rrrh/tiny_sid_chip/analog_sim/svf/SVF_DESIGN.md

# State Variable Filter (SVF) — Switched-Capacitor Design Document

## Overview

The SVF is a 2nd-order switched-capacitor (SC) analog filter implemented in the
IHP SG13G2 130nm BiCMOS process at VDD = 1.2V. It replaces the previous gm-C
topology to solve the capacitor scaling problem: 800 pF ideal caps would need
~730 µm per side in MIM, which is 16× the entire TT tile.

The SC approach replaces continuous-time transconductance (gm) with a clocked
capacitor: `R_eff = 1/(f_clk × C_sw)`, enabling audio-band filtering with
small on-chip MIM capacitors. The filter center frequency is tuned by changing
the switching clock frequency (digital control), and the Q factor is tuned via
a 4-bit binary-weighted capacitor array.

## Architecture

```
  fc[10:0] → [16-bit NCO] → sc_clk → [NOL Clock Gen] → phi1, phi2
                                                          │    │
  Vin ──→ [SC_R_in: Csw_in] ──→ sum1 ──→ [OTA1] ──→ BP
                                  ↑         │              │
  LP ───→ [SC_R_fb: Csw_in] ──→─┘        C_int1           │
                                  ↑        (feedback)       │
  BP ───→ [SC_R_q: C_q_array] ──┘                          │
                                                            │
                              sum2 ←── [SC_R2: Csw_in] ←── BP
                               │
                             [OTA2]        [OTA3: inverter]
                               │               │
                             C_int2         lp = -lp_neg
                               │
                             lp_neg ──→ [OTA3] ──→ LP (feedback)

  Output Mux (sel[1:0]):                 Q Tuning (res[3:0]):
  ┌──────────┬──────────────┐            ┌──────────────────────────────┐
  │ sel[1:0] │  Output      │            │ q[3:0] = 15 - res[3:0]      │
  │──────────┼──────────────│            │ C_sw_q = Σ q[i]·2^i·4.9fF   │
  │   00     │  HP          │            │ Q = C_sw_in / C_sw_q         │
  │   01     │  BP          │            │ Range: Q=1 to ∞ (self-osc)   │
  │   10     │  LP          │            └──────────────────────────────┘
  │   11     │  Bypass      │
  └──────────┴──────────────┘
```

## SC Resistor Equivalent

A switched-capacitor resistor uses a small capacitor (C_sw) clocked between
two nodes at frequency f_clk to emulate a resistor:

```
  phi1 closes    phi2 closes
     │               │
     ▼               ▼
  in ──[sw1]── C_sw ──[sw2]── out
                │
               GND

  R_eff = 1 / (f_clk × C_sw)
```

With C_sw = 73.5 fF and f_clk = 93.75 kHz:
  R_eff = 1 / (93750 × 73.5e-15) = 145 MΩ

The non-overlapping clock generator (NOL) ensures phi1 and phi2 never
overlap, preventing charge sharing between input and output.

## Design Equations

```
         f_clk × C_sw
f₀ = ─────────────────      (Hz)
          2π × C_int

         C_sw_in
Q  = ──────────              (Tow-Thomas topology)
          C_sw_q

C_sw_q = Σ q[i] × 2^i × C_q_unit    (i = 0..3)

q[3:0] = 15 - res[3:0]       (SID convention: res=0 → flat, res=15 → self-oscillation)
```

## Component Values

| Parameter | Value | Notes |
|---|---|---|
| C_sw_in | 73.5 fF | 7×7 µm MIM (input & feedback SC resistors) |
| C_int | 1.1 pF | 27×27 µm MIM, 2 per SVF |
| C_q_unit | 4.9 fF | 1.8×1.8 µm MIM (damping cap unit) |
| C_sw_q range | 4.9 fF – 73.5 fF | 4-bit binary, q[3:0] = 15-res |
| f_clk | 9 kHz – 1.85 MHz | 2048 steps via 16-bit phase accumulator |
| f₀ | ~4.9 Hz – ~10 kHz | Tracks f_clk linearly, K ≈ 4.87 Hz/step |
| Q range | 1.0 – ∞ (self-osc) | C_sw_in / C_sw_q |
| OTAs | 2 | 5T diff pair (same as gm-C) |
| VCM | 0.6 V | VDD/2 |

## Frequency Tuning

The switching clock is generated by a 16-bit phase accumulator (NCO) from
the 24 MHz system clock. The SID's 11-bit `fc[10:0]` register controls the
accumulator increment:

```
  increment = fc[10:0] + fc[10:2]     // fc × 5/4 scaling

  reg [15:0] phase_acc;
  wire sc_clk = phase_acc[15];        // MSB is the output clock

  always @(posedge sys_clk)
      phase_acc <= phase_acc + {3'b0, increment};
```

The phase accumulator gives 2048 frequency steps (11-bit fc register):

| fc[10:0] | increment | f_clk (Hz) | f₀ (Hz) |
|---|---|---|---|
| 1 | 1 | 366 | ~4.9 |
| 6 | 7 | 2563 | ~34 |
| 100 | 125 | 45,776 | ~612 |
| 500 | 625 | 228,882 | ~3060 |
| 1024 | 1280 | 468,750 | ~6267 |
| 2047 | 2558 | 936,890 | ~12526 |

For the SID-compatible range (~30 Hz to ~10 kHz), fc values 6–2047 cover
the full spectrum with ~4.87 Hz/step resolution.

This replaces the analog bias DAC used in the gm-C version, providing fine-
grained digital frequency control matching the original SID's 11-bit range.

## Q Tuning

Q is controlled by a 4-bit binary-weighted MIM capacitor array (C_sw_q)
that acts as the SC damping resistor. The SID resonance register is
inverted to match convention: `q[3:0] = 15 - res[3:0]`.

```
  BP ──[sw_q0]── C_q0 (1× = 4.9 fF) ──┐
  BP ──[sw_q1]── C_q1 (2× = 9.8 fF) ──┤
  BP ──[sw_q2]── C_q2 (4× = 19.6 fF) ──┼── summing node (SC damping)
  BP ──[sw_q3]── C_q3 (8× = 39.2 fF) ──┘
```

| res[3:0] | q[3:0] | C_sw_q (fF) | Q = C_sw_in/C_sw_q |
|---|---|---|---|
| 0 | 15 | 73.5 | 1.0 (flat) |
| 1 | 14 | 68.6 | 1.07 |
| 2 | 13 | 63.7 | 1.15 |
| 3 | 12 | 58.8 | 1.25 |
| 4 | 11 | 53.9 | 1.36 |
| 5 | 10 | 49.0 | 1.50 |
| 6 | 9 | 44.1 | 1.67 |
| 7 | 8 | 39.2 | 1.88 |
| 8 | 7 | 34.3 | 2.14 |
| 9 | 6 | 29.4 | 2.50 |
| 10 | 5 | 24.5 | 3.0 |
| 11 | 4 | 19.6 | 3.75 |
| 12 | 3 | 14.7 | 5.0 |
| 13 | 2 | 9.8 | 7.5 |
| 14 | 1 | 4.9 | 15.0 |
| 15 | 0 | 0 | ∞ (self-oscillation) |

The `filt_res[3:0]` register maps through `q = 15 - res`, then q[3:0]
drives the cap switches directly. All 16 SID resonance levels are covered
with 15 distinct Q values plus self-oscillation.

## OTA Topology

Each OTA is a 5-transistor differential pair with PMOS current mirror load
(identical to the gm-C version):

```
          VDD            VDD
           │              │
      ┌────┴────┐    ┌────┴────┐
      │  M3 (P) │    │  M4 (P) │     PMOS active load
      │  W=2µm  ├────┤  W=2µm  │     (current mirror)
      │  L=0.5µm│    │  L=0.5µm│
      └────┬────┘    └────┬────┘
           │              │
           │              ├────────── Vout
           │              │
      ┌────┴────┐    ┌────┴────┐
      │  M1 (N) │    │  M2 (N) │     NMOS differential pair
 V+ ──┤  W=4µm  │    │  W=4µm  ├── V-
      │  L=0.5µm│    │  L=0.5µm│
      └────┬────┘    └────┬────┘
           └──────┬───────┘
                  │
             ┌────┴────┐
             │  M5 (N) │              NMOS tail current source
    Vbias ───┤  W=2µm  │
             │  L=0.5µm│
             └────┬────┘
                  │
                 VSS
```

The SC SVF uses 3 OTAs (Tow-Thomas topology): 2 inverting integrators
plus 1 unity-gain inverter for sign correction. SC resistors handle
the summing and damping functions that previously required dedicated
gm stages in the gm-C version.

## Layout

The SC SVF macro (`svf_2nd`) occupies **66 × 72 µm** (compacted):

```
  ┌──────────────────────────────────────────────────────────────────────┐
  │                          VDD rail (Metal3)                    72 µm │
  ├──────────────────────────────────────────────────────────────────────┤
  │  [OTA1: int1]     [OTA2: int2]                ← 2 OTAs       y≈56 │
  ├──────────────────────────────────────────────────────────────────────┤
  │                              [NOL Clock Gen]   ← clock gen    y≈50 │
  ├──────────────────────────────────────────────────────────────────────┤
  │  ┌──────────┐  ┌──────────┐  ┌─────────────────────────────┐       │
  │  │ C_int1   │  │ C_int2   │  │  C_Q array (4-bit)         │       │
  │  │ 27×27 µm │  │ 27×27 µm │  │  7×7 to 14×28 µm          │ y≈23 │
  │  │ (1.1 pF) │  │ (1.1 pF) │  │  (73.5 fF to 588 fF)      │       │
  │  └──────────┘  └──────────┘  └─────────────────────────────┘       │
  │  ┌────┐ ┌────┐                                                     │
  │  │C_sw│ │C_sw│               ← SC switching caps            y≈19  │
  │  │7×7 │ │7×7 │                 (73.5 fF each)                      │
  │  └────┘ └────┘                                                     │
  │  [SW1][SW2][SW3][SW4]         ← CMOS switches     ┌──────┐        │
  │                                                    │ MUX  │  y≈4  │
  │                                                    │ 4×   │        │
  │                                                    │ NMOS │        │
  │                                                    └──────┘        │
  ├──────────────────────────────────────────────────────────────────────┤
  │                          VSS rail (Metal3)                     0 µm │
  └──────────────────────────────────────────────────────────────────────┘
  0 µm                                                            62 µm
```

### Pin Map

| Pin | Layer | Edge | Y (µm) | Direction |
|-----|---|---|---|---|
| vin | Metal2 | Left | 36 | Input |
| vout | Metal2 | Right | 36 | Output |
| sel0 | Metal2 | Left | 10 | Input (mux control) |
| sel1 | Metal2 | Left | 16 | Input (mux control) |
| sc_clk | Metal2 | Left | 52 | Input (switching clock) |
| q0 | Metal2 | Left | 56 | Input (C_Q bit 0) |
| q1 | Metal2 | Left | 58 | Input (C_Q bit 1) |
| q2 | Metal2 | Left | 60 | Input (C_Q bit 2) |
| q3 | Metal2 | Left | 62 | Input (C_Q bit 3) |
| vdd | Metal3 | Top | 70–72 | Power |
| vss | Metal3 | Bottom | 0–2 | Ground |

### Component Summary

| Component | Count | Size | Notes |
|---|---|---|---|
| OTA (5T) | 3 | NMOS dp: W=4µm L=0.5µm | 2 integrators + 1 inverter |
| | | PMOS load: W=2µm L=0.5µm | |
| | | NMOS tail: W=2µm L=0.5µm | |
| MIM cap (C_int) | 2 | 27.1 × 27.1 µm each | ~1.1 pF |
| MIM cap (C_sw) | 3 | 7.0 × 7.0 µm each | ~73.5 fF (in, fb, int2) |
| MIM cap (C_q) | 4 | 1.8×1.8 to 3.6×7.2 µm | Binary-weighted (4.9 fF unit) |
| CMOS switch | 8 | N: W=2µm L=0.13µm | SC resistors + C_Q |
| | | P: W=4µm L=0.13µm | |
| NOL clock gen | 1 | 8 transistors | 4 CMOS gate pairs |
| NMOS mux | 4 | W=2µm L=0.13µm | Output select |

### Area Comparison (gm-C vs SC)

| | gm-C SVF | SC SVF |
|---|---|---|
| OTAs | 4 × 5T = 20 transistors | 3 × 5T = 15 transistors |
| Bias circuits | 2 mirrors (4 transistors) | None (digital clock) |
| Caps | 2 × 25.8² µm (C_int only) | 2 × 27.1² + 3 × 7² + 4 × C_q |
| Switches | 4 NMOS (mux only) | 8 CMOS + 4 NMOS mux |
| Clock gen | None | 8 transistors (NOL) |
| Fill | ~45% | ~51% |
| fc tuning | Analog bias DAC | Digital clock divider |
| Q tuning | Analog bias DAC | Digital cap switches |

## Digital Interface Changes

The SC SVF replaces the two analog bias current inputs with digital controls:

| Old (gm-C) | New (SC) | Type | Control |
|---|---|---|---|
| ibias_fc (analog) | sc_clk (digital) | Clock | Programmable divider from 24 MHz |
| ibias_q (analog) | q0, q1, q2, q3 | Digital | Direct from filt_res[3:0] |

This eliminates the `bias_dac_2ch` module from the digital top-level, replacing
it with a 16-bit phase accumulator (~16 FFs + 13-bit adder) and a 4-bit
subtractor for Q register inversion.

## Verification

1. `ngspice -b svf/sc_svf_tb.spice` — standalone SC SVF simulation
2. `ngspice -b full_chain/full_chain_tb.spice` — DAC → SC SVF → ADC chain
3. `python3 layout/gen_sc_svf.py` — generate GDS
4. `python3 layout/run_drc.py macros/gds/svf_2nd.gds` — DRC check

## Simulation Results

The SC SVF has been characterized via the `filter_sweep` simulation suite,
which sweeps LP/BP/HP modes across 4 Q values (0.5, 1, 2, 5) and 4 cutoff
frequencies (250, 500, 1000, 1500 Hz) using a fixed 500 Hz input sine —
16 simulation segments total. Key results:

- **Low-pass**: passes signal when fc > f_in, attenuates when fc < f_in;
  resonant peak visible at Q = 5.
- **Band-pass**: peaks at fc = f_in (500 Hz), attenuated above and below;
  higher Q sharpens the peak.
- **High-pass**: passes signal when fc < f_in, attenuates when fc > f_in;
  resonant peak at Q = 5.

The full analog chain (R-2R DAC → SC SVF → SAR ADC) has also been verified
end-to-end via the `full_chain` and `full_sweep` simulations, including PWM
recovery through a 3rd-order RC filter.

See [`analog_sim/STATUS.md`](../STATUS.md) for complete results, plots, and
pass/fail status of all analog macro simulations.

## Behavioral Simulation Model

The `svf_2nd` Verilog source (`macros/nl/svf_2nd.v`) includes a behavioral
model gated by `` `ifdef BEHAVIORAL_SIM ``, enabling full-chain digital
simulation without analog tools. The model uses `real` arithmetic and
executes one SVF iteration per `posedge sc_clk`:

```
alpha = C_sw_in / C_int = 73.5 fF / 1.1 pF ≈ 0.0668
q_code = 15 - res                  // SID convention inversion
damping = C_sw_in / (q_code * C_q_unit)  // = 73.5 / (q_code × 4.9)

hp = input - damping*bp - lp
bp += alpha * hp
lp += alpha * bp                   // uses updated bp (Tow-Thomas SVF)
```

Internal registers `sim_data_in[7:0]` and `sim_data_out[7:0]` carry the
8-bit data bus (the physical single-bit `vin`/`vout` pins carry only the MSB
for real-analog connectivity). The parent module connects these via
hierarchical references: `u_dac.sim_data_out` → `u_svf.sim_data_in` and
`u_svf.sim_data_out` → `u_adc.sim_data_in`.

Output mode is selected by `{sel1, sel0}`: 00=LP, 01=BP, 10=HP, 11=bypass.
The output is AC-coupled (centered at 128), clamped to 0–255.
