rrrh/tiny_sid_chip/verification/pwm_comp/doc/pwm_comp_schematic.md

# CACE Summary for pwm_comp

**netlist source**: schematic

| Parameter | Tool | Result | Min Limit  |  Min Value | Typ Target |  Typ Value | Max Limit  |  Max Value |  Status  |
| :--- | :--- | :--- | ---: | ---: | ---: | ---: | ---: | ---: | :---: |
| Input Offset Voltage | ngspice | vos | | | | | 50.0 mV |  10.376 mV | Pass ✅ |
| Trip Point | ngspice | trip_point | 0.4 V | 0.590 V | | | 0.8 V | 0.593 V | Pass ✅ |
| tPLH | ngspice | t_plh | | | | | 100.0 ns |  86.291 ns | Pass ✅ |
| tPHL | ngspice | t_phl | | | | | 100.0 ns | 1.323 ns | Pass ✅ |

## Plots

## offset_vs_corner

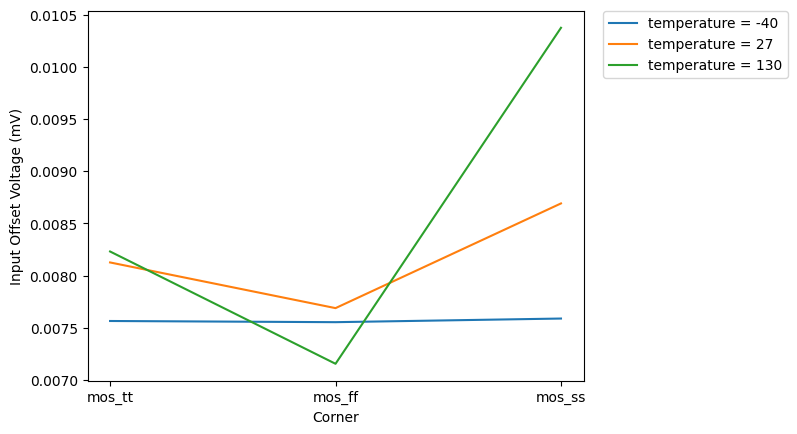
[picture p1: verification/pwm_comp/doc/pwm_comp/schematic/offset_vs_corner.png]
offset_vs_corner


## offset_vs_temp

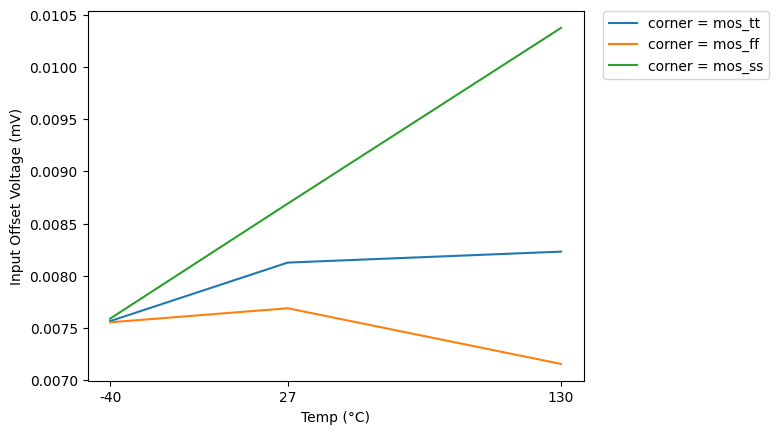
[picture p2: verification/pwm_comp/doc/pwm_comp/schematic/offset_vs_temp.png]
offset_vs_temp


## delay_vs_corner

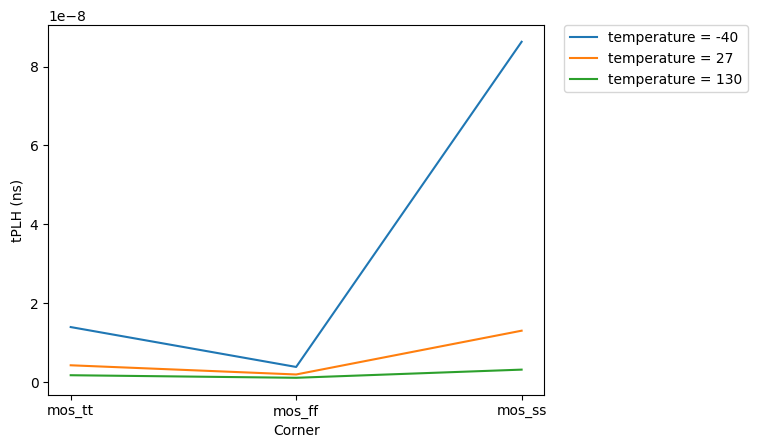
[picture p3: verification/pwm_comp/doc/pwm_comp/schematic/delay_vs_corner.png]
delay_vs_corner


## delay_vs_temp

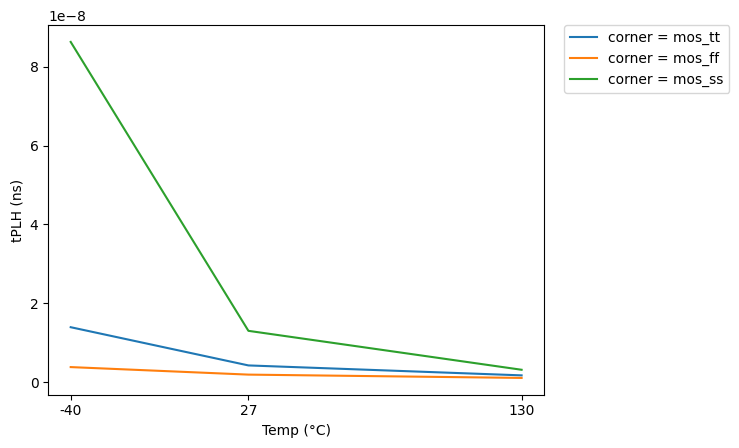
[picture p4: verification/pwm_comp/doc/pwm_comp/schematic/delay_vs_temp.png]
delay_vs_temp
