rrrh/tiny_sid_chip/docs/rc_filter.pdf

### uo_out[1]

PDM 1-bit @ 50 MHz

R1

1.0 kΩ

C2

1 µF

### Audio Out

to headphones
or amplifier

4.7 nFC1

fc =

1
2πR1C1

≈ 34 kHz with R1=1 kΩ, C1=4.7 nF

C2 is optional — blocks DC offset when driving an AC-coupled amplifier input
