rrrh/tiny_sid_chip/verification/sar_adc_8bit/doc/sar_adc_8bit_schematic.md

# CACE Summary for sar_adc_8bit

**netlist source**: schematic

| Parameter | Tool | Result | Min Limit  |  Min Value | Typ Target |  Typ Value | Max Limit  |  Max Value |  Status  |
| :--- | :--- | :--- | ---: | ---: | ---: | ---: | ---: | ---: | :---: |
| Resolve Time | ngspice | t_resolve | | | | | 5.0 ns | | Skip 🟧 |
| Correct Decision | ngspice | decision | 1.0 | | | | | | Skip 🟧 |
| INL | ngspice | inl | | | | | 0.5 LSB | | Skip 🟧 |
| DNL | ngspice | dnl | | | | | 0.5 LSB | | Skip 🟧 |
| INL | ngspice | inl | | | | | 0.5 LSB | | Skip 🟧 |
| DNL | ngspice | dnl | | | | | 0.5 LSB | | Skip 🟧 |
| Conversion Time | ngspice | conv_time_ns | | | | | 1000 ns | | Skip 🟧 |

## Plots
