rrrh/tiny_sid_chip/verification/svf_2nd/doc/svf_2nd_schematic.md

# CACE Summary for svf_2nd

**netlist source**: schematic

| Parameter | Tool | Result | Min Limit  |  Min Value | Typ Target |  Typ Value | Max Limit  |  Max Value |  Status  |
| :--- | :--- | :--- | ---: | ---: | ---: | ---: | ---: | ---: | :---: |
| Center Frequency | ngspice | f0 | any | | any | | any | | Skip 🟧 |
| BP Peak Gain | ngspice | peak_gain | -30.0 dB | | | | 20.0 dB | | Skip 🟧 |
| Measured Q | ngspice | q_meas | any | | any | | any | | Skip 🟧 |
| HF Gain | ngspice | hf_gain | -1.0 dB | | | | 1.0 dB | | Skip 🟧 |
| -3dB Frequency | ngspice | f_3db | any | | any | | any | | Skip 🟧 |
| DC Gain | ngspice | dc_gain | -1.0 dB | | | | 1.0 dB | | Skip 🟧 |
| -3dB Frequency | ngspice | f_3db | any | | any | | any | | Skip 🟧 |

## Plots
