rrrh/tiny_sid_chip/analog_sim/full_chain/full_chain_plot.png

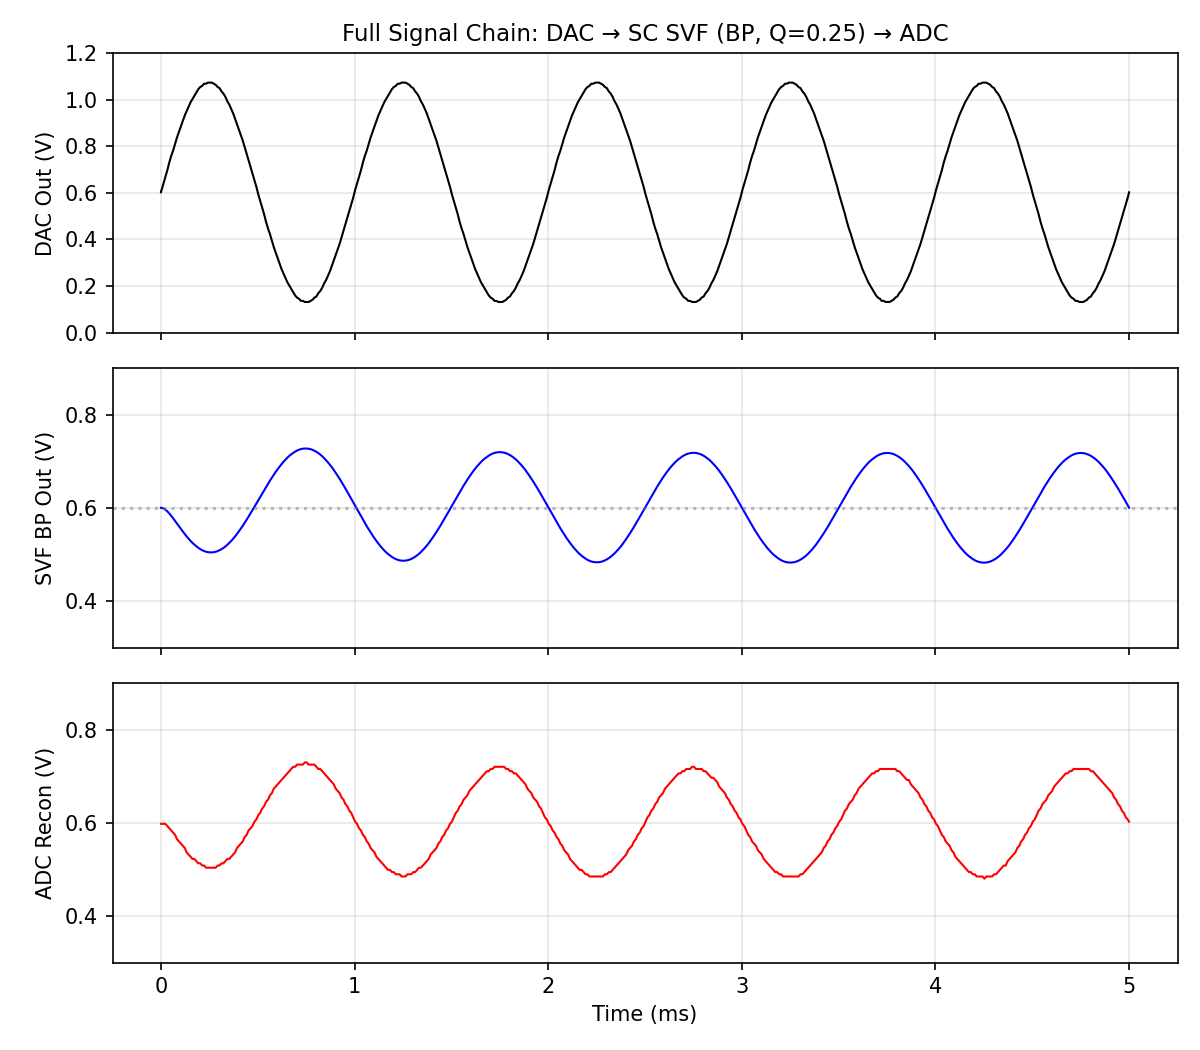
analog_sim/full_chain/full_chain_plot.png
