rrrh/tiny_sid_chip/analog_sim/full_chain/waveform_440.png

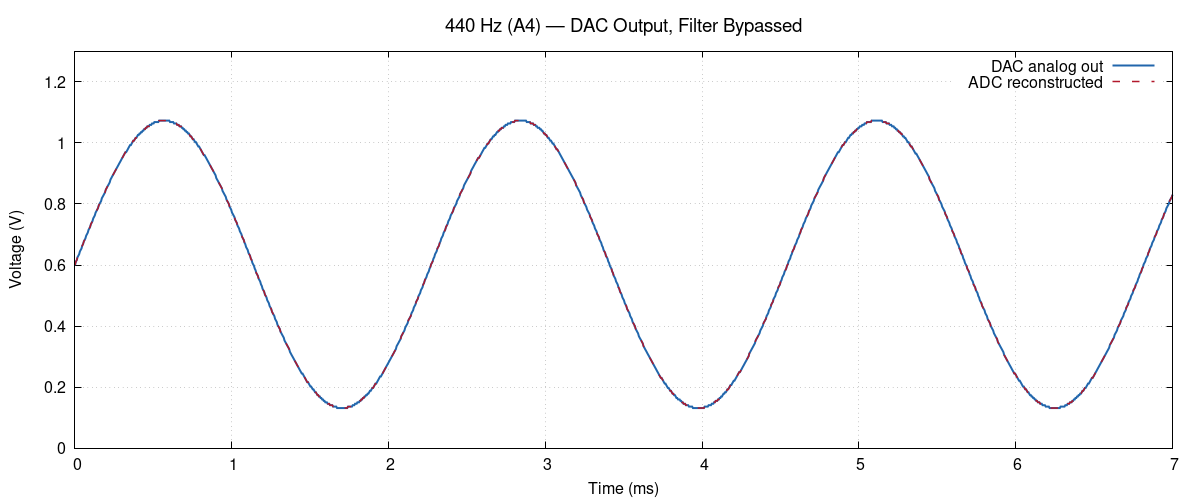
analog_sim/full_chain/waveform_440.png
