rrrh/tiny_sid_chip/analog_sim/full_chain/waveform_880.png

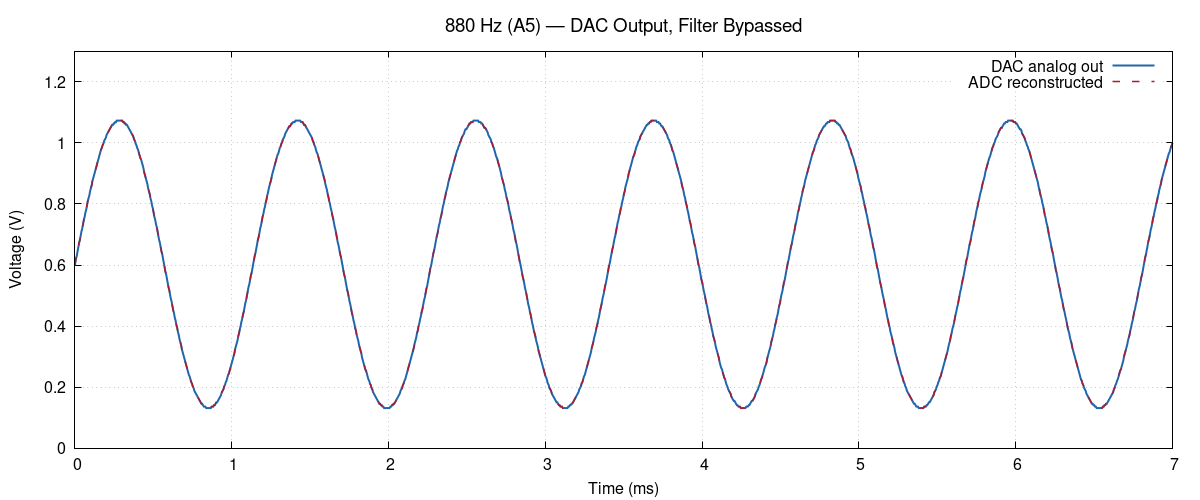
analog_sim/full_chain/waveform_880.png
