rrrh/tiny_sid_chip/analog_sim/sc_svf_summary.png

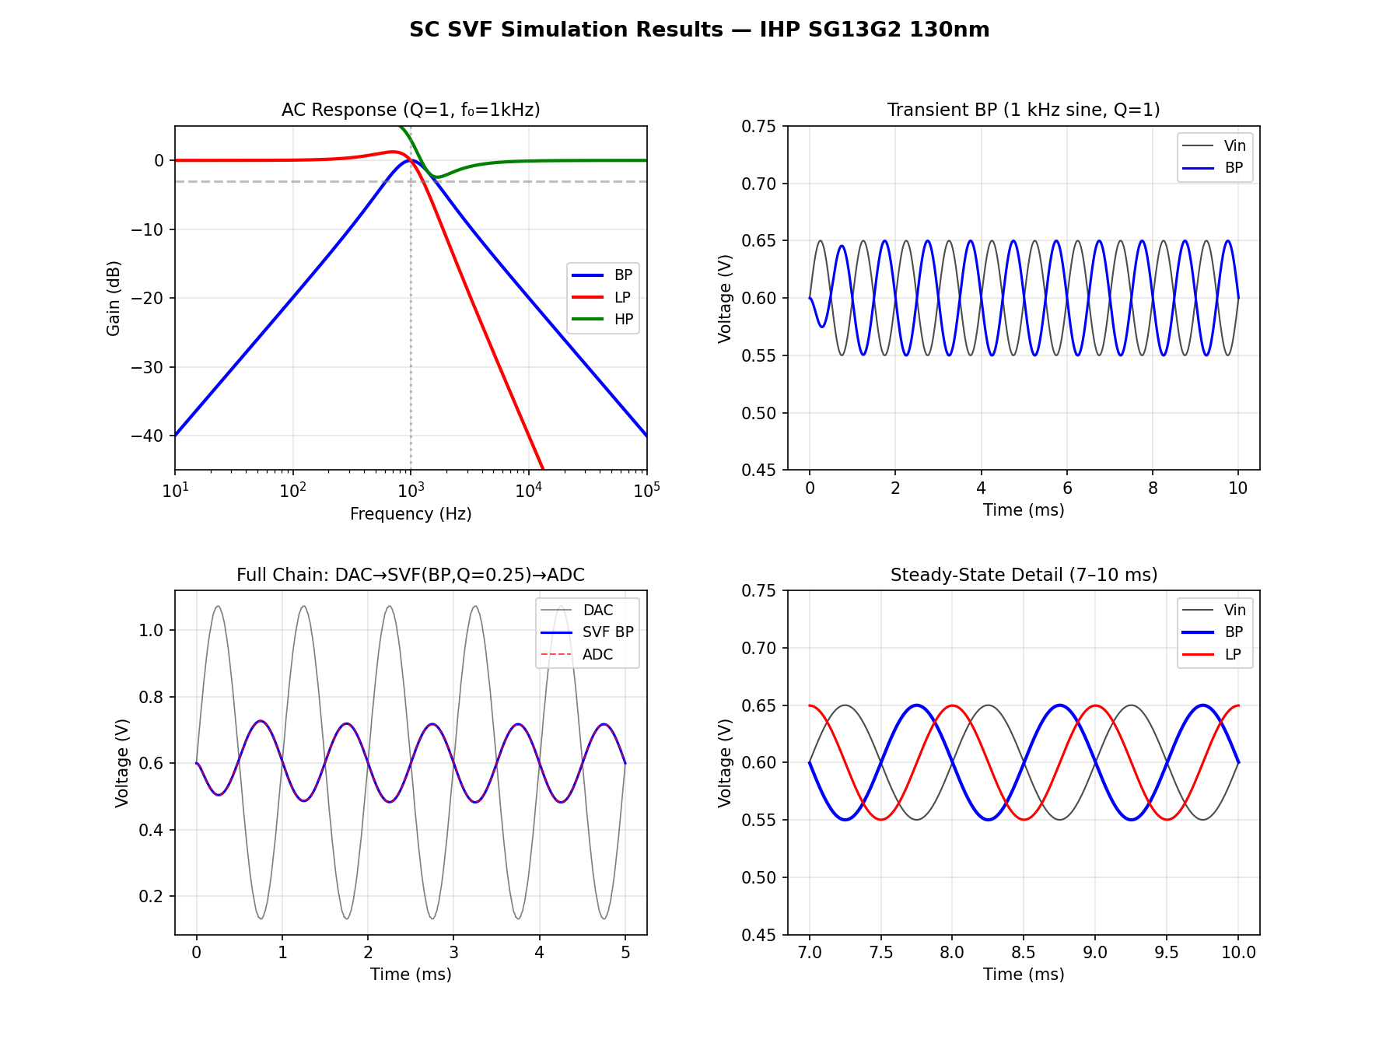
analog_sim/sc_svf_summary.png
