rrrh/tiny_sid_chip/analog_sim/svf/sc_svf_ac_response.png

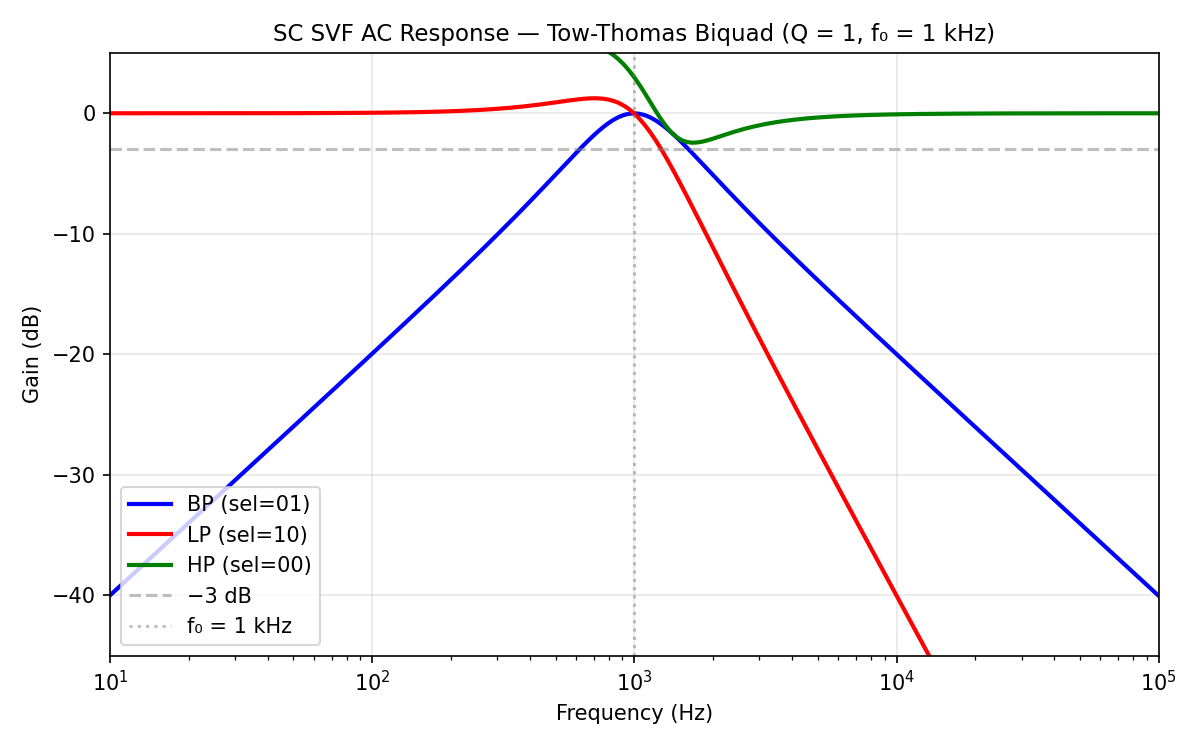
analog_sim/svf/sc_svf_ac_response.png
