rrrh/tiny_sid_chip/analog_sim/svf/sc_svf_transient.png

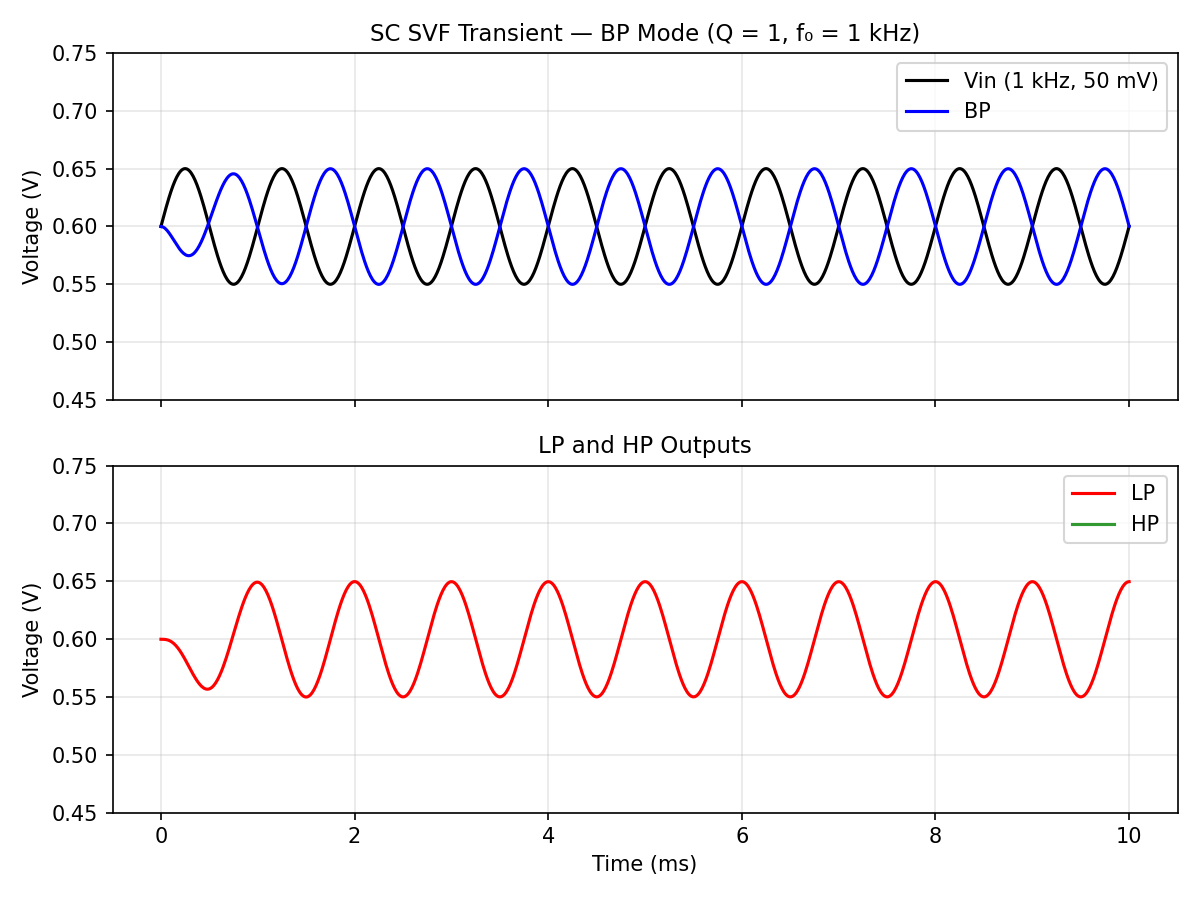
analog_sim/svf/sc_svf_transient.png
