rrrh/tiny_sid_chip/docs/adsr_fsm.png

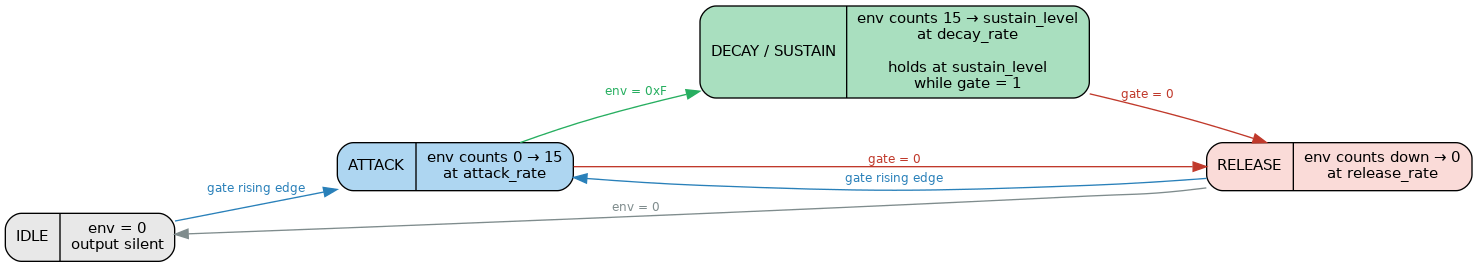
docs/adsr_fsm.png
