rrrh/tiny_sid_chip/docs/pwm_bode_plot.png

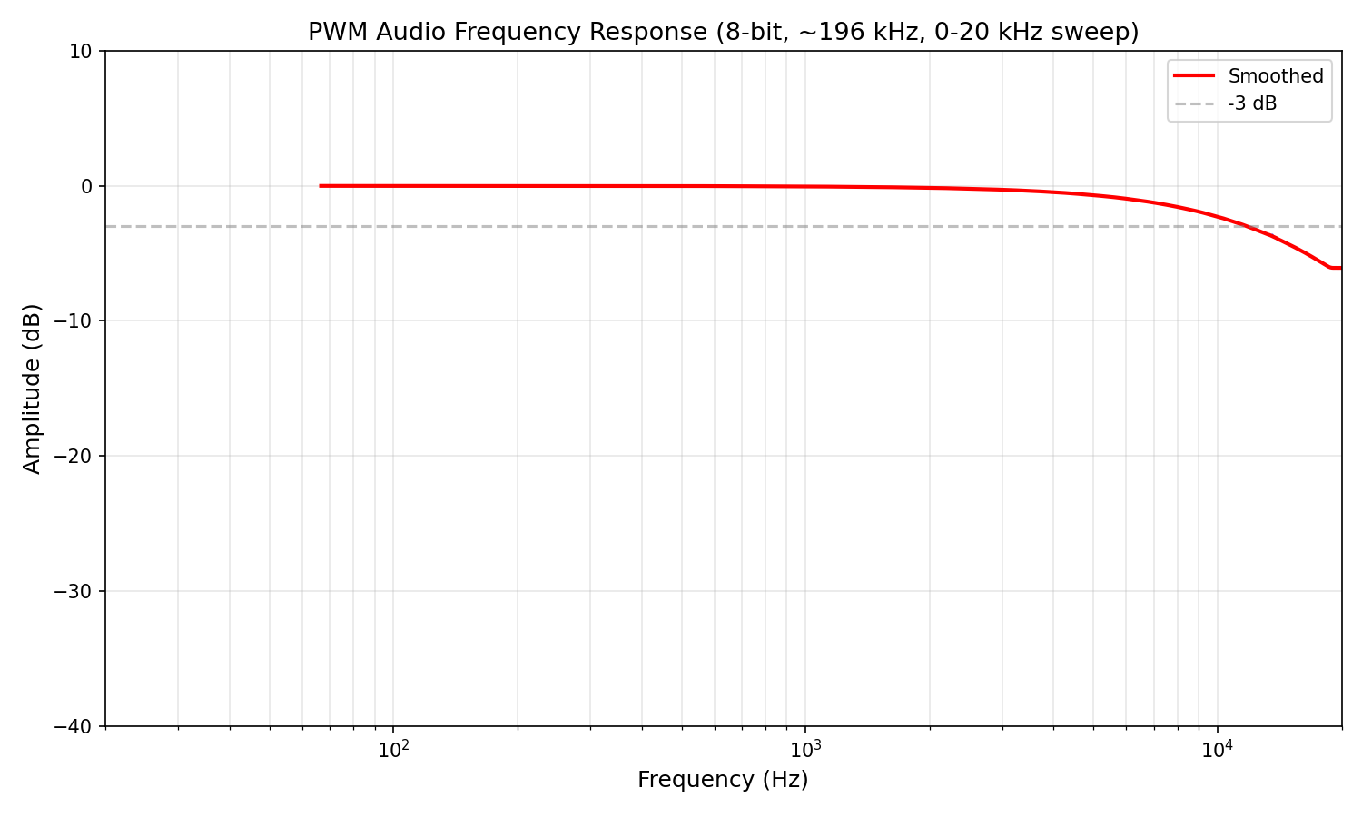
docs/pwm_bode_plot.png
