rrrh/tiny_sid_chip/docs/pwm_rc_filter_bode.png

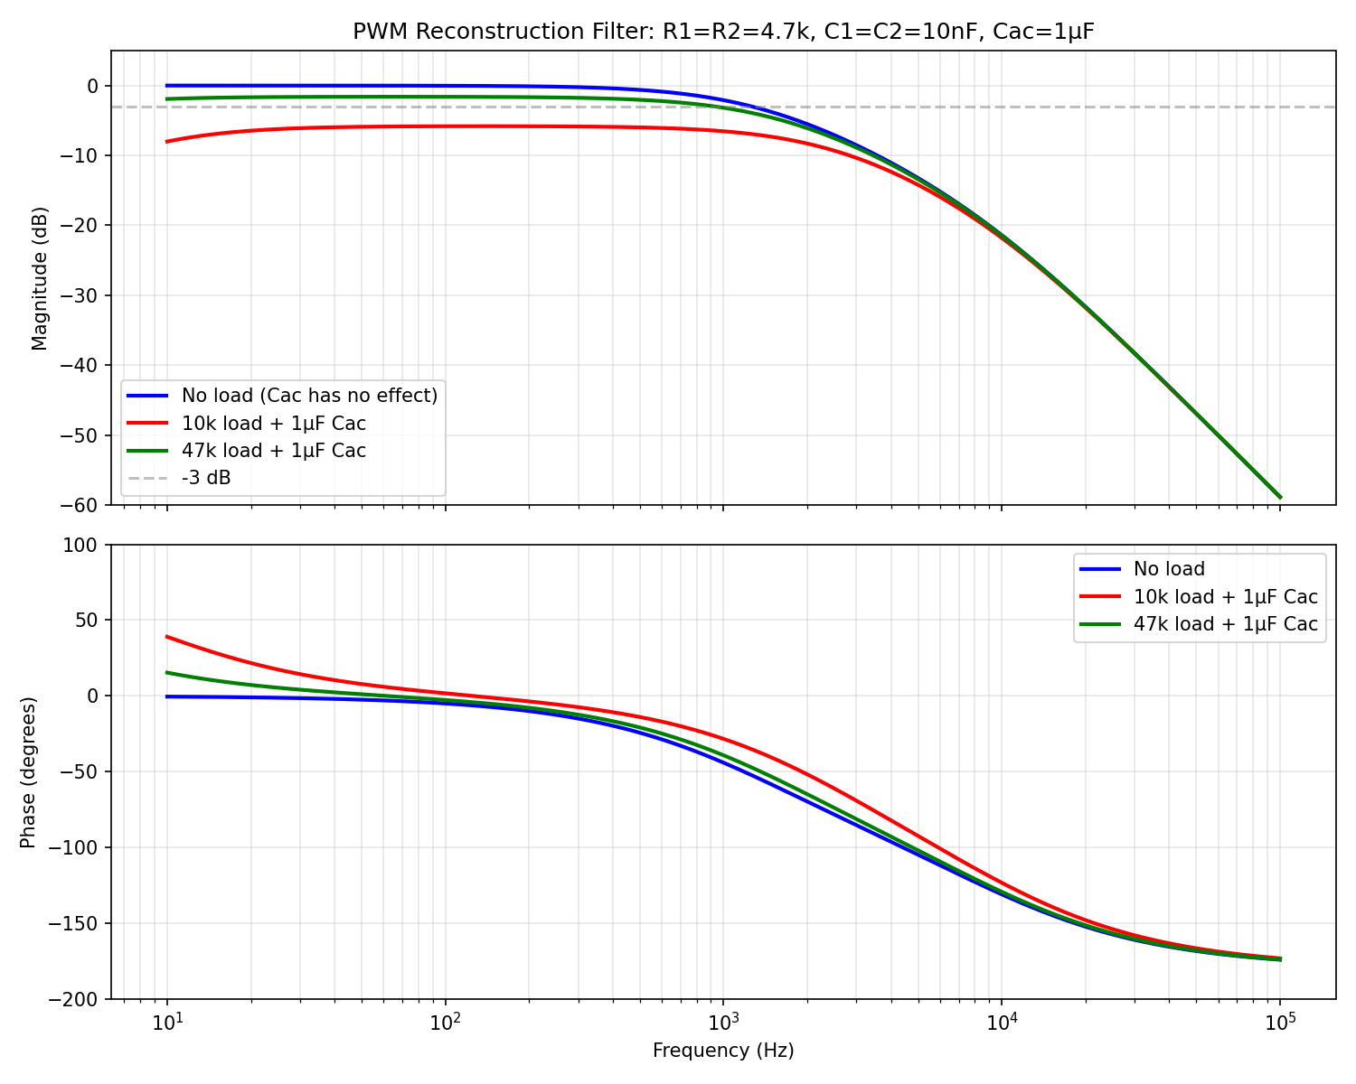
docs/pwm_rc_filter_bode.png
