rrrh/tiny_sid_chip/verification/r2r_dac_8bit/doc/r2r_dac_8bit_datasheet.md

# r2r_dac_8bit Datasheet

**8-bit R-2R DAC with CMOS complementary shunt switches**

| Field | Value |
|---|---|
| PDK | ihp-sg13g2 |
| Designer | shue |
| Created | March 3, 2026 |
| License | Apache 2.0 |
| Characterization Date | 2026-03-10 19:30 |
| Total Tests | 15 |
| Passed | 15 |
| Failed | 0 |
| **Overall** | **PASS** |

## Pin Description

| Pin | Direction | Type | Description |
|-----|---|---|---|
| d0 | input | digital | Digital input bit 0 (LSB) |
| d1 | input | digital | Digital input bit 1 |
| d2 | input | digital | Digital input bit 2 |
| d3 | input | digital | Digital input bit 3 |
| d4 | input | digital | Digital input bit 4 |
| d5 | input | digital | Digital input bit 5 |
| d6 | input | digital | Digital input bit 6 |
| d7 | input | digital | Digital input bit 7 (MSB) |
| vout | output | signal | Analog output voltage (0..vdd V) |
| vdd | inout | power | Positive power supply (1.08..1.32 V) |
| vss | inout | ground | Ground |

## Default Conditions

| Condition | Display | Typical | Unit |
|---|---|---|---|
| vdd | Vdd | 1.2 | V |
| temperature | Temp | 27 | °C |
| corner | Corner | mos_tt |  |

## Characterization Results

### Static Linearity

DC transfer function — sweep all 256 codes

**Specifications:**

| Parameter | Display | Unit | Min | Max |
|---|---|---|-----|-----|
| inl | INL | LSB |  | 5.0 |
| dnl | DNL | LSB |  | 5.0 |

**Results:**

| vdd | temperature | corner | inl | dnl | Status |
|---|---|---|---|---|---|
| 1.2 | 27 | mos_tt | 2.6648 | 2.5932 | PASS |
| 1.2 | 27 | mos_ff | 1.7565 | 1.9462 | PASS |
| 1.2 | 27 | mos_ss | 3.3798 | 3.2134 | PASS |

**Plots:**

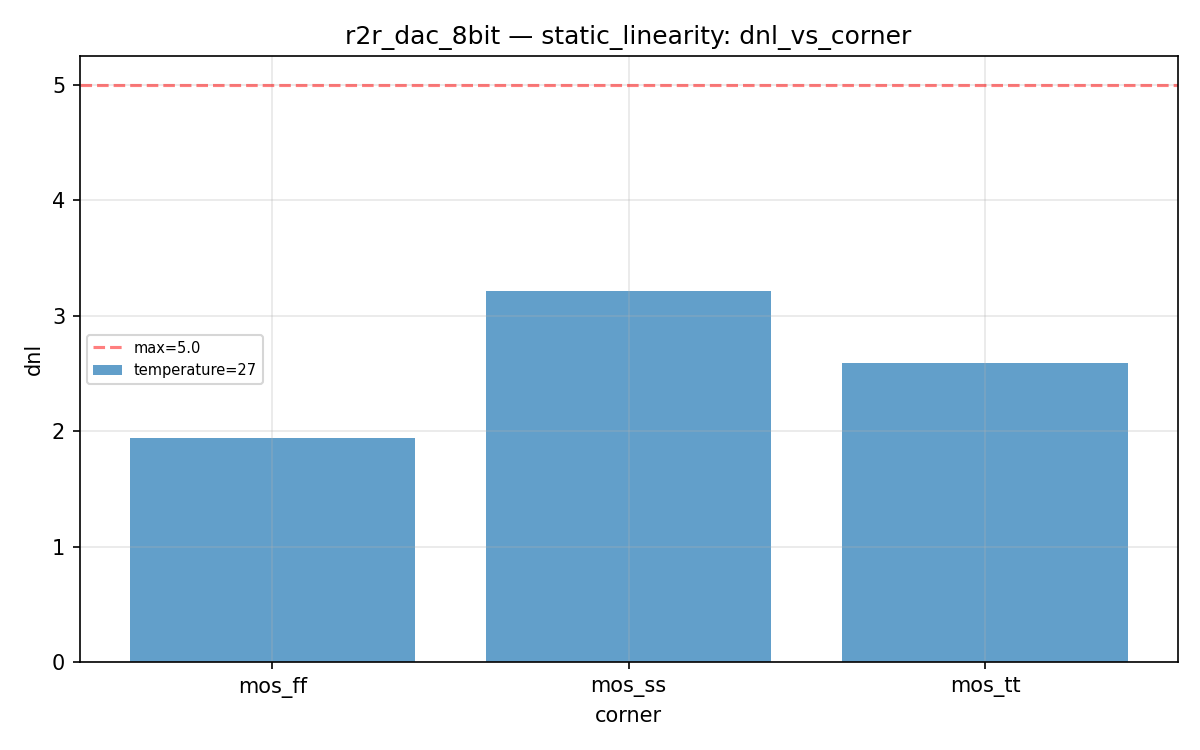
[picture p59: verification/plots/r2r_dac_8bit/r2r_dac_8bit_static_linearity_dnl_vs_corner.png]


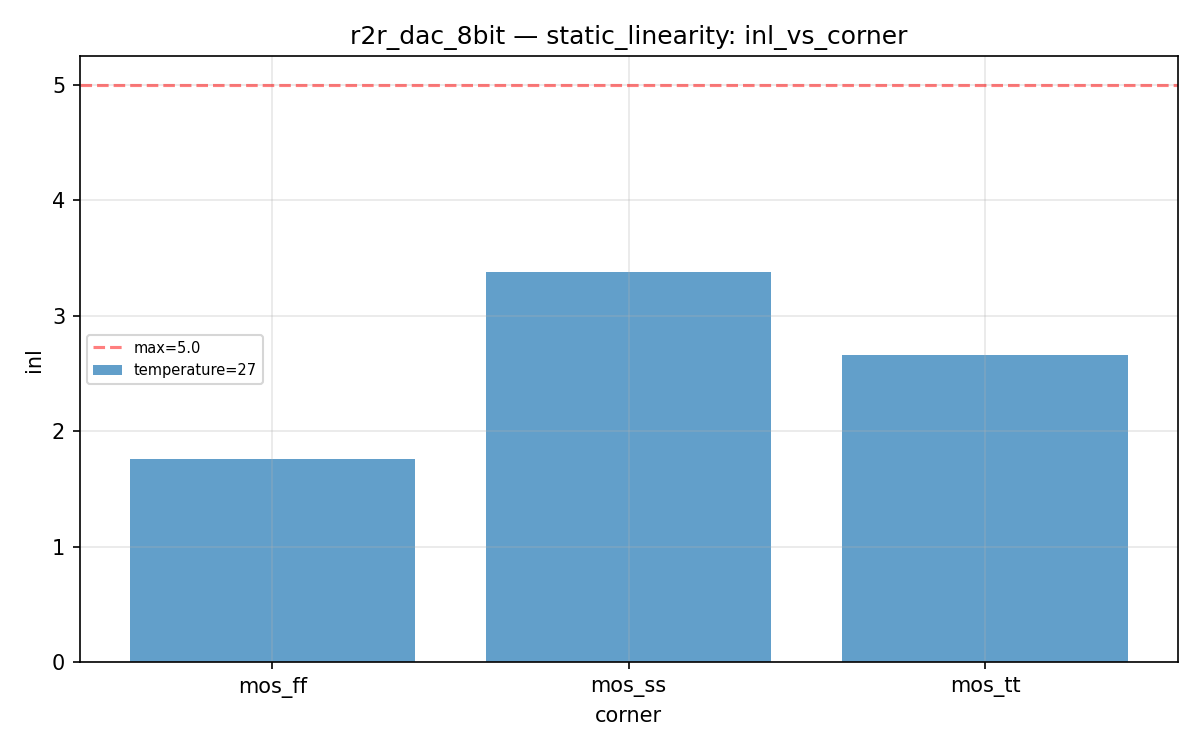
[picture p60: verification/plots/r2r_dac_8bit/r2r_dac_8bit_static_linearity_inl_vs_corner.png]


### Linearity vs Temperature

INL/DNL across temperature

**Specifications:**

| Parameter | Display | Unit | Min | Max |
|---|---|---|-----|-----|
| inl | INL | LSB |  | 5.0 |
| dnl | DNL | LSB |  | 5.0 |

**Results:**

| vdd | temperature | corner | inl | dnl | Status |
|---|---|---|---|---|---|
| 1.2 | -40 | mos_tt | 1.9674 | 1.5290 | PASS |
| 1.2 | 27 | mos_tt | 2.6648 | 2.5932 | PASS |
| 1.2 | 130 | mos_tt | 3.7876 | 4.8425 | PASS |

**Plots:**

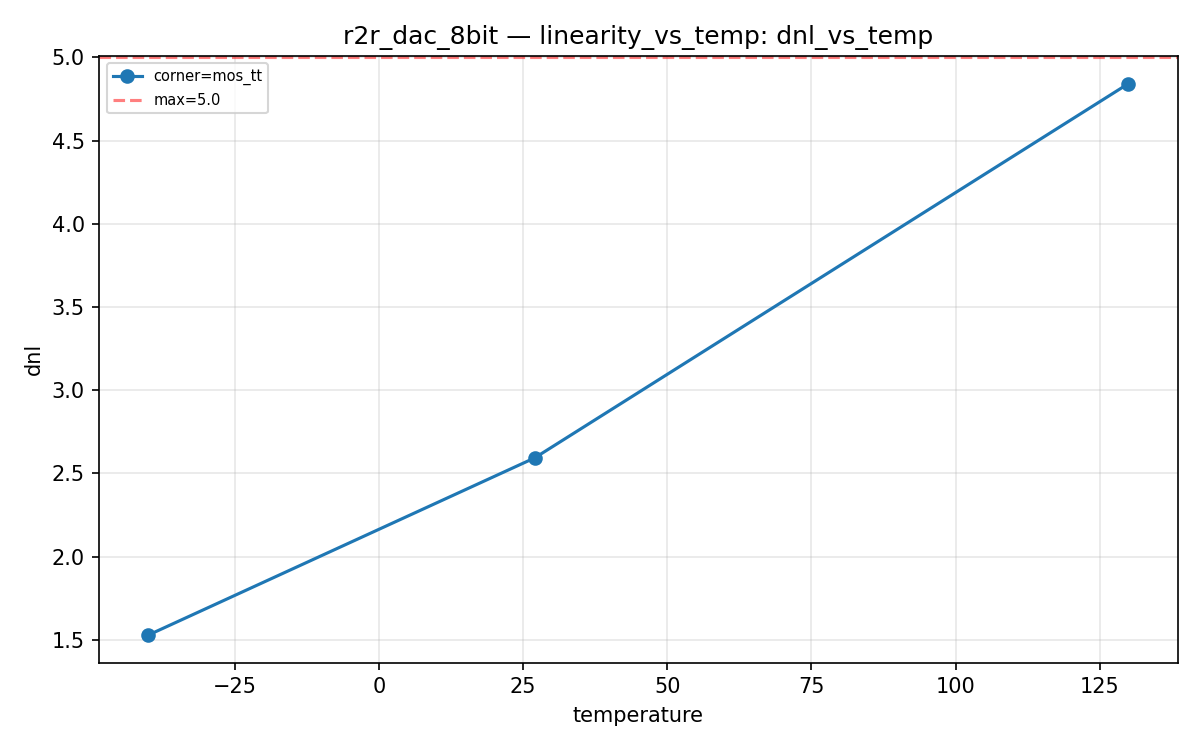
[picture p61: verification/plots/r2r_dac_8bit/r2r_dac_8bit_linearity_vs_temp_dnl_vs_temp.png]


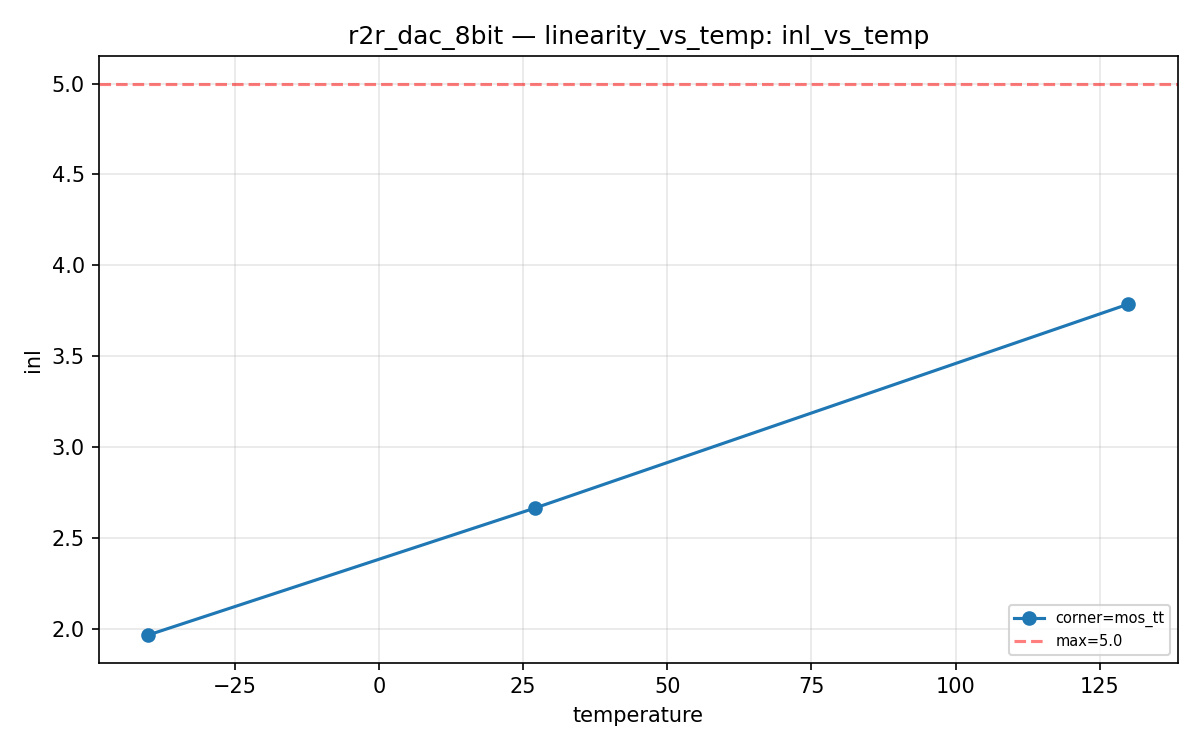
[picture p62: verification/plots/r2r_dac_8bit/r2r_dac_8bit_linearity_vs_temp_inl_vs_temp.png]


### Full Scale Range

Output voltage at code 0 and code 255

**Specifications:**

| Parameter | Display | Unit | Min | Max |
|---|---|---|-----|-----|
| vout_min | Vout_min | V |  | 0.05 |
| vout_max | Vout_max | V | 1.1 |  |

**Results:**

| vdd | temperature | corner | vout_min | vout_max | Status |
|---|---|---|---|---|---|
| 1.2 | -40 | mos_tt | 0.0073 | 1.1967 | PASS |
| 1.2 | -40 | mos_ff | 0.0073 | 1.1967 | PASS |
| 1.2 | -40 | mos_ss | 0.0073 | 1.1967 | PASS |
| 1.2 | 27 | mos_tt | 0.0075 | 1.1972 | PASS |
| 1.2 | 27 | mos_ff | 0.0075 | 1.1972 | PASS |
| 1.2 | 27 | mos_ss | 0.0075 | 1.1971 | PASS |
| 1.2 | 130 | mos_tt | 0.0080 | 1.1977 | PASS |
| 1.2 | 130 | mos_ff | 0.0080 | 1.1977 | PASS |
| 1.2 | 130 | mos_ss | 0.0081 | 1.1977 | PASS |

## Composite Plots

### R2R Dac Transfer Inl Dnl

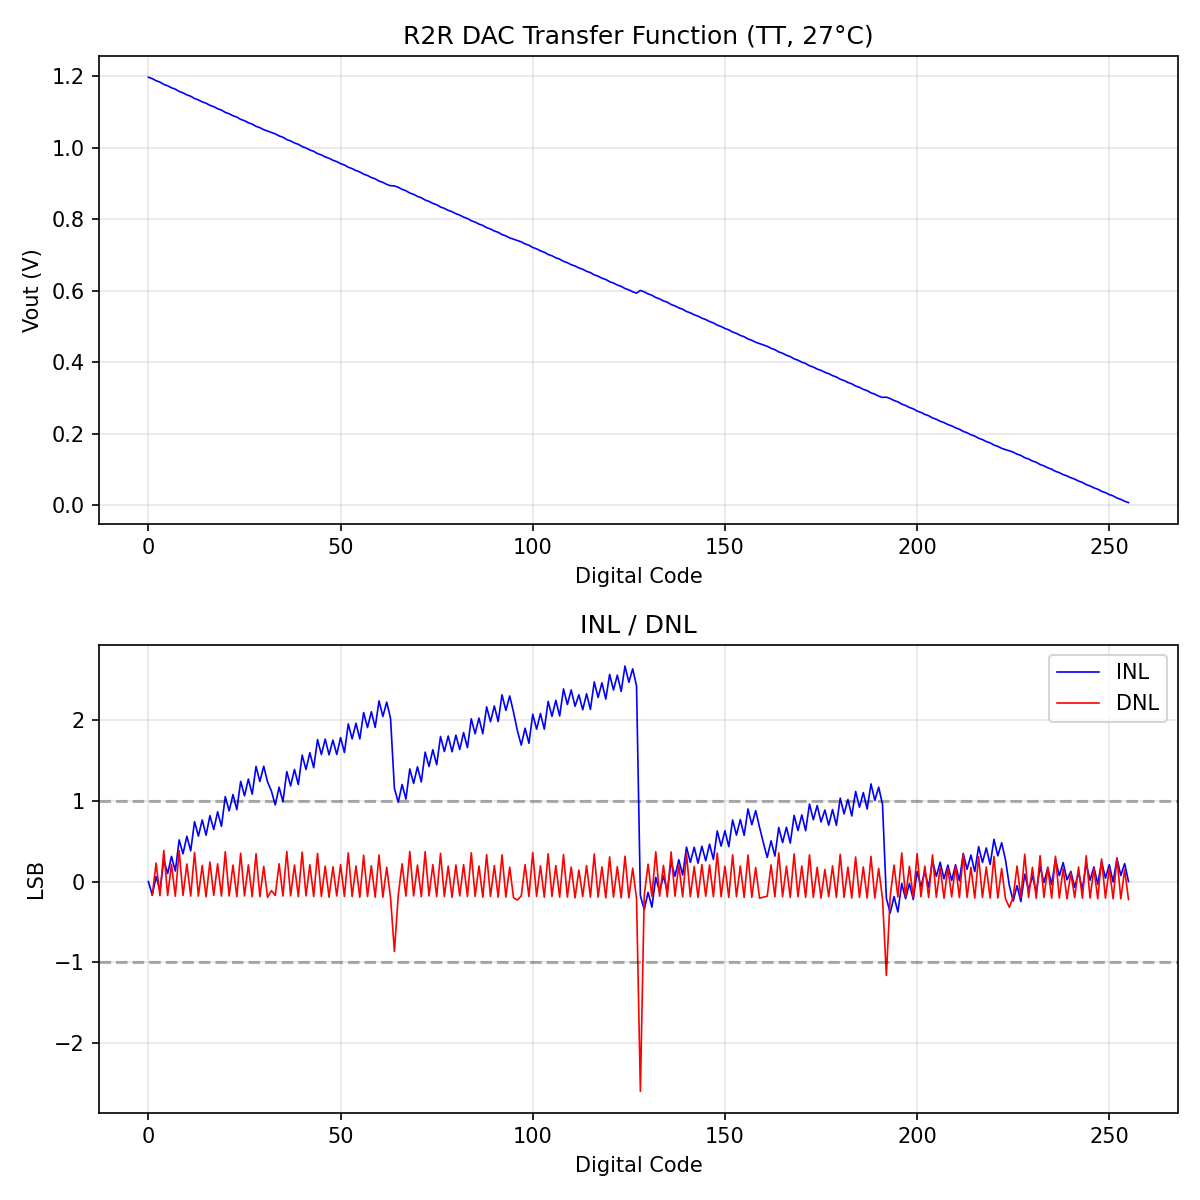
[picture p63: verification/plots/r2r_dac_8bit/r2r_dac_transfer_inl_dnl.png]


---
*Generated by run_cace_sims.py on 2026-03-10 19:30:10*
