rrrh/tiny_sid_chip/verification/r2r_dac_8bit/doc/r2r_dac_8bit_rcx.md

# CACE Summary for r2r_dac_8bit

**netlist source**: rcx

| Parameter | Tool | Result | Min Limit  |  Min Value | Typ Target |  Typ Value | Max Limit  |  Max Value |  Status  |
| :--- | :--- | :--- | ---: | ---: | ---: | ---: | ---: | ---: | :---: |
| INL | ngspice | inl | | | | | 3.0 LSB | | Skip 🟧 |
| DNL | ngspice | dnl | | | | | 3.0 LSB | | Skip 🟧 |
| INL | ngspice | inl | | | | | 3.0 LSB | | Skip 🟧 |
| DNL | ngspice | dnl | | | | | 3.0 LSB | | Skip 🟧 |
| Vout_min | ngspice | vout_min | | | | | 0.05 V | | Skip 🟧 |
| Vout_max | ngspice | vout_max | 1.1 V | | | | | | Skip 🟧 |

## Plots
