rrrh/tiny_sid_chip/verification/svf_2nd/doc/svf_2nd_datasheet.md

# svf_2nd Datasheet

**2nd-order SC state variable filter (Tow-Thomas biquad)**

| Field | Value |
|---|---|
| PDK | ihp-sg13g2 |
| Designer | shue |
| Created | March 3, 2026 |
| License | Apache 2.0 |
| Characterization Date | 2026-03-09 15:35 |
| Total Tests | 24 |
| Passed | 24 |
| Failed | 0 |
| **Overall** | **PASS** |

## Pin Description

| Pin | Direction | Type | Description |
|-----|---|---|---|
| vin | input | signal | Audio input signal (0..vdd V) |
| vout | output | signal | Filtered output (LP/BP/HP/bypass via sel mux) (0..vdd V) |
| sel0 | input | digital | Output mux select bit 0 |
| sel1 | input | digital | Output mux select bit 1 |
| sc_clk | input | digital | Switching clock (sets center frequency) |
| q0 | input | digital | Q tuning bit 0 (LSB) |
| q1 | input | digital | Q tuning bit 1 |
| q2 | input | digital | Q tuning bit 2 |
| q3 | input | digital | Q tuning bit 3 (MSB) |
| vdd | inout | power | Positive power supply (1.08..1.32 V) |
| vss | inout | ground | Ground |

## Default Conditions

| Condition | Display | Typical | Unit |
|---|---|---|---|
| vdd | Vdd | 1.2 | V |
| f_clk | f_clk | 93750 | Hz |
| q_code | Q code | 4 |  |
| sel0 | sel0 | 1.2 | V |
| sel1 | sel1 | 0 | V |

## Characterization Results

### Band-Pass Response

BP mode — center frequency, peak gain, and Q factor

**Specifications:**

| Parameter | Display | Unit | Min | Max |
|---|---|---|-----|-----|
| f0 | Center Frequency | Hz | any | any |
| peak_gain | BP Peak Gain | dB | -30.0 | 20.0 |
| q_meas | Measured Q |  | any | any |

**Results:**

| vdd | sel0 | sel1 | f_clk | q_code | f0 | peak_gain | q_meas | Status |
|---|---|---|---|---|---|---|---|---|
| 1.2 | 1.2 | 0 | 23437.5 | 1 | 251.1886 | -0.0054 | 1.0097 | PASS |
| 1.2 | 1.2 | 0 | 23437.5 | 4 | 251.1886 | -12.0437 | 0.2525 | PASS |
| 1.2 | 1.2 | 0 | 23437.5 | 8 | 251.1886 | -18.0639 | 0.1263 | PASS |
| 1.2 | 1.2 | 0 | 23437.5 | 15 | 251.1886 | -23.5237 | 0.0673 | PASS |
| 1.2 | 1.2 | 0 | 93750 | 1 | 1000.0000 | -0.0045 | 1.0051 | PASS |
| 1.2 | 1.2 | 0 | 93750 | 4 | 1000.0000 | -12.0436 | 0.2513 | PASS |
| 1.2 | 1.2 | 0 | 93750 | 8 | 1000.0000 | -18.0639 | 0.1257 | PASS |
| 1.2 | 1.2 | 0 | 93750 | 15 | 1000.0000 | -23.5237 | 0.0670 | PASS |
| 1.2 | 1.2 | 0 | 375000 | 1 | 3981.0717 | -0.0044 | 1.0003 | PASS |
| 1.2 | 1.2 | 0 | 375000 | 4 | 3981.0717 | -12.0436 | 0.2501 | PASS |
| 1.2 | 1.2 | 0 | 375000 | 8 | 3981.0717 | -18.0639 | 0.1251 | PASS |
| 1.2 | 1.2 | 0 | 375000 | 15 | 3981.0717 | -23.5237 | 0.0667 | PASS |
| 1.2 | 1.2 | 0 | 1500000 | 1 | 1.5849e+04 | -0.0050 | 0.9954 | PASS |
| 1.2 | 1.2 | 0 | 1500000 | 4 | 1.5849e+04 | -12.0436 | 0.2490 | PASS |
| 1.2 | 1.2 | 0 | 1500000 | 8 | 1.5849e+04 | -18.0639 | 0.1245 | PASS |
| 1.2 | 1.2 | 0 | 1500000 | 15 | 1.5849e+04 | -23.5237 | 0.0664 | PASS |

**Plots:**

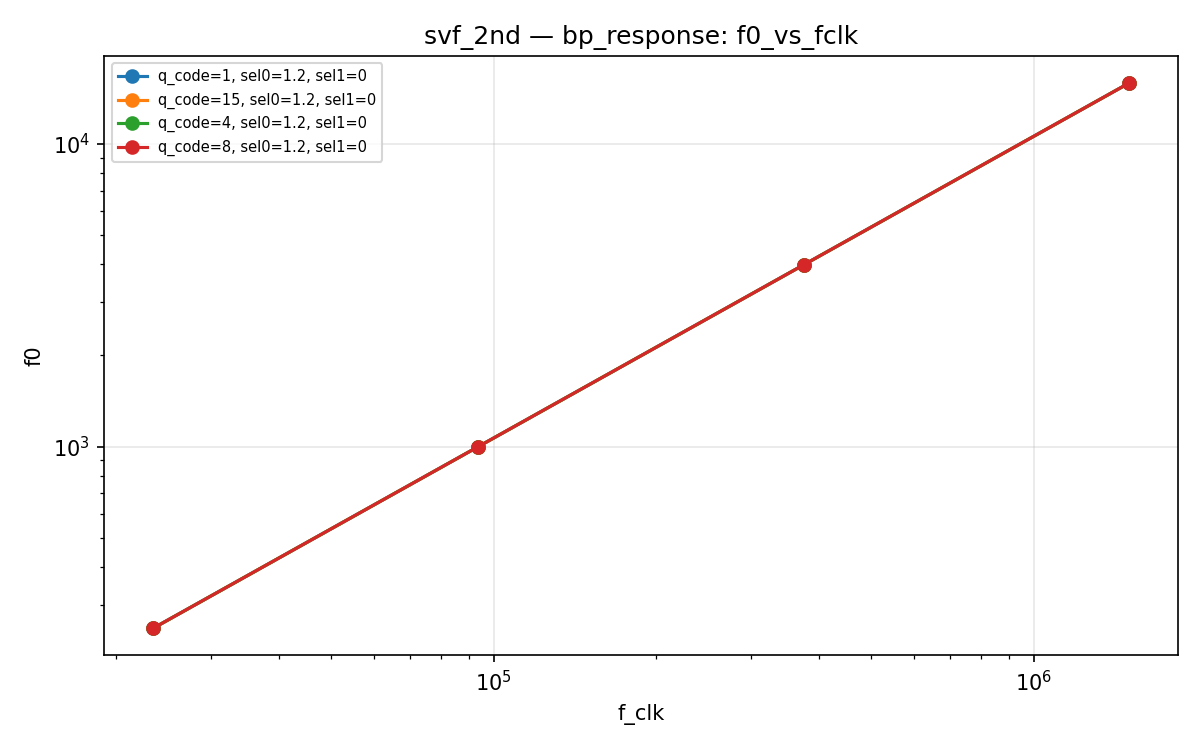
[picture p79: verification/plots/svf_2nd/svf_2nd_bp_response_f0_vs_fclk.png]


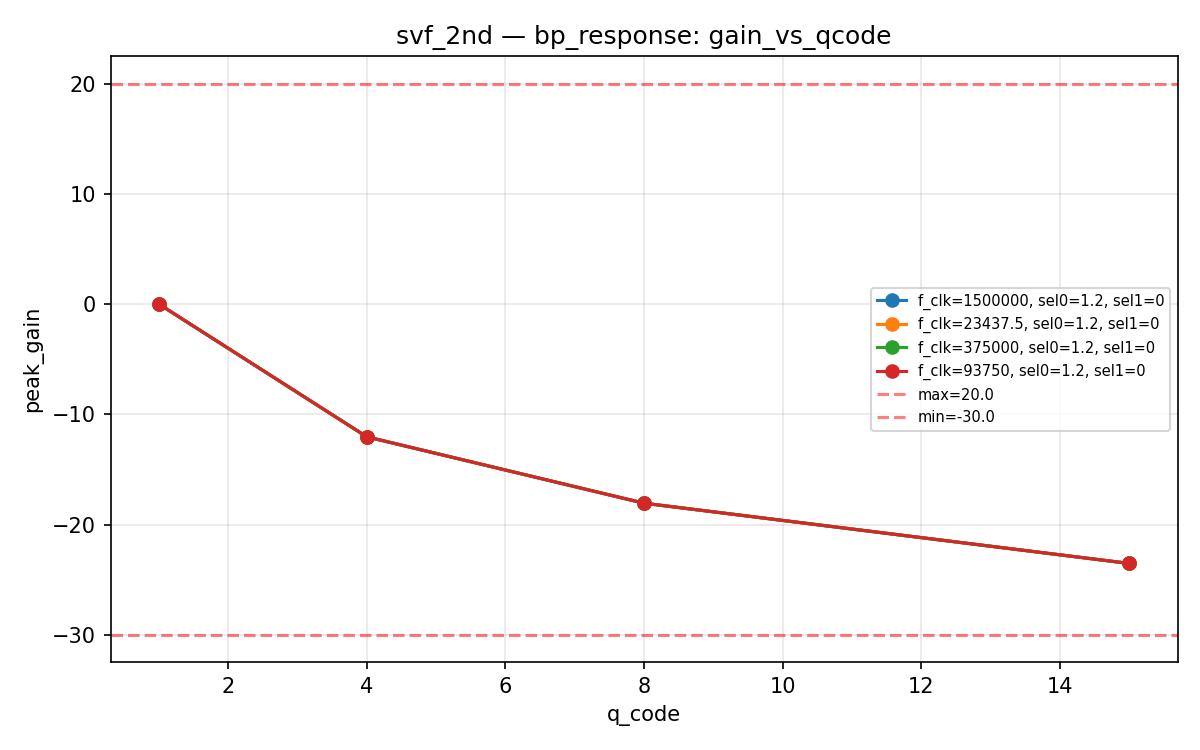
[picture p80: verification/plots/svf_2nd/svf_2nd_bp_response_gain_vs_qcode.png]


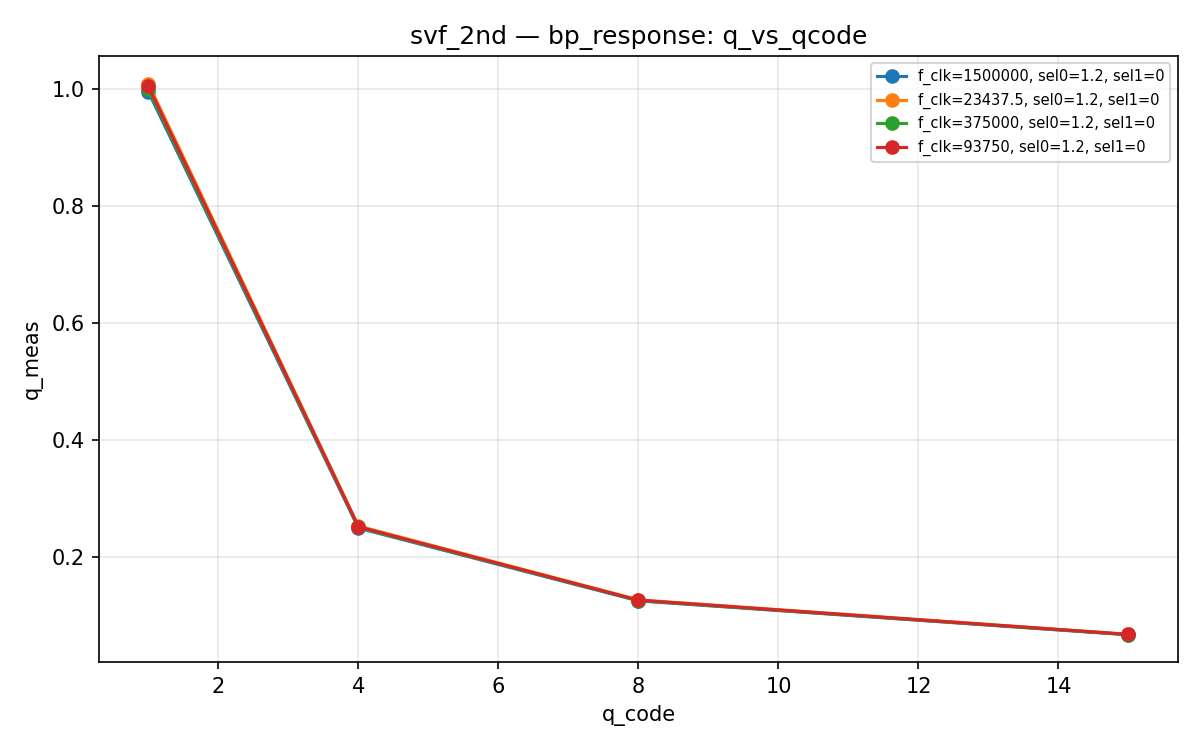
[picture p81: verification/plots/svf_2nd/svf_2nd_bp_response_q_vs_qcode.png]


### High-Pass Response

HP mode — high-frequency gain and -3dB corner frequency

**Specifications:**

| Parameter | Display | Unit | Min | Max |
|---|---|---|-----|-----|
| hf_gain | HF Gain | dB | -1.0 | 1.0 |
| f_3db | -3dB Frequency | Hz | any | any |

**Results:**

| vdd | sel0 | sel1 | f_clk | q_code | hf_gain | f_3db | Status |
|---|---|---|---|---|---|---|---|
| 1.2 | 0 | 0 | 23437.5 | 4 | -8.6989e-04 | 121.7411 | PASS |
| 1.2 | 0 | 0 | 93750 | 4 | -8.9013e-04 | 487.0067 | PASS |
| 1.2 | 0 | 0 | 375000 | 4 | -0.0012 | 1947.8041 | PASS |
| 1.2 | 0 | 0 | 1500000 | 4 | -0.0064 | 7772.0182 | PASS |

**Plots:**

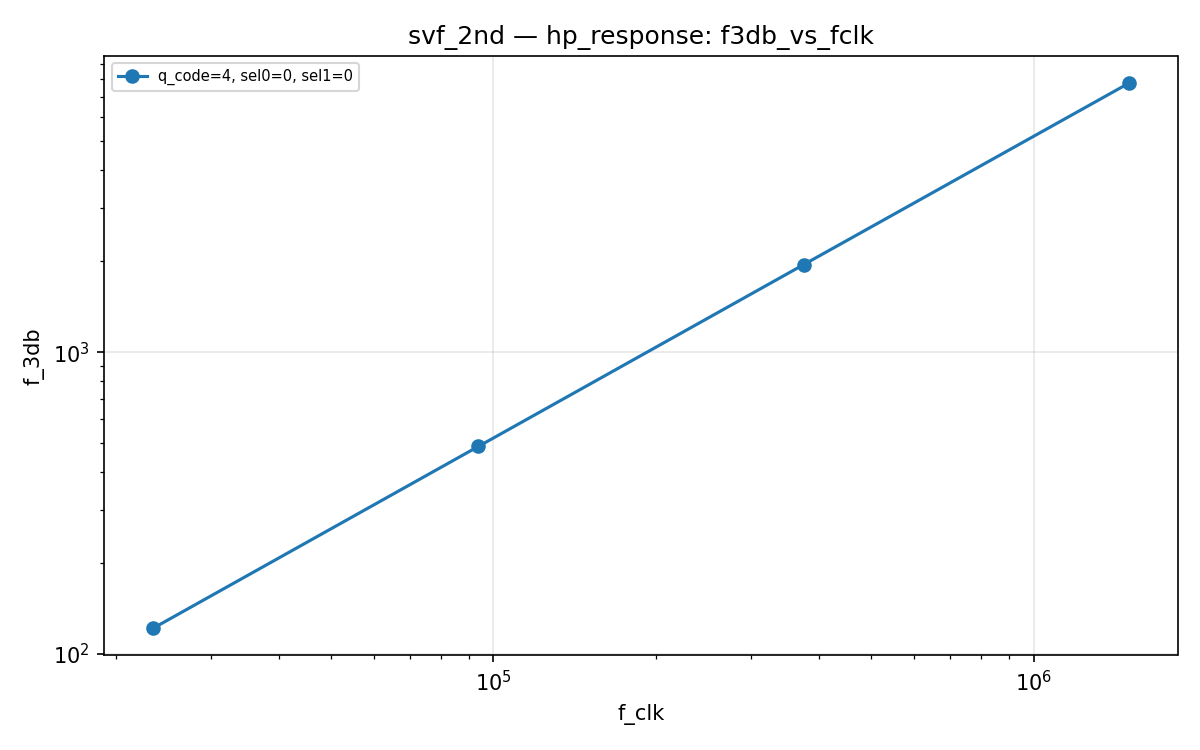
[picture p82: verification/plots/svf_2nd/svf_2nd_hp_response_f3db_vs_fclk.png]


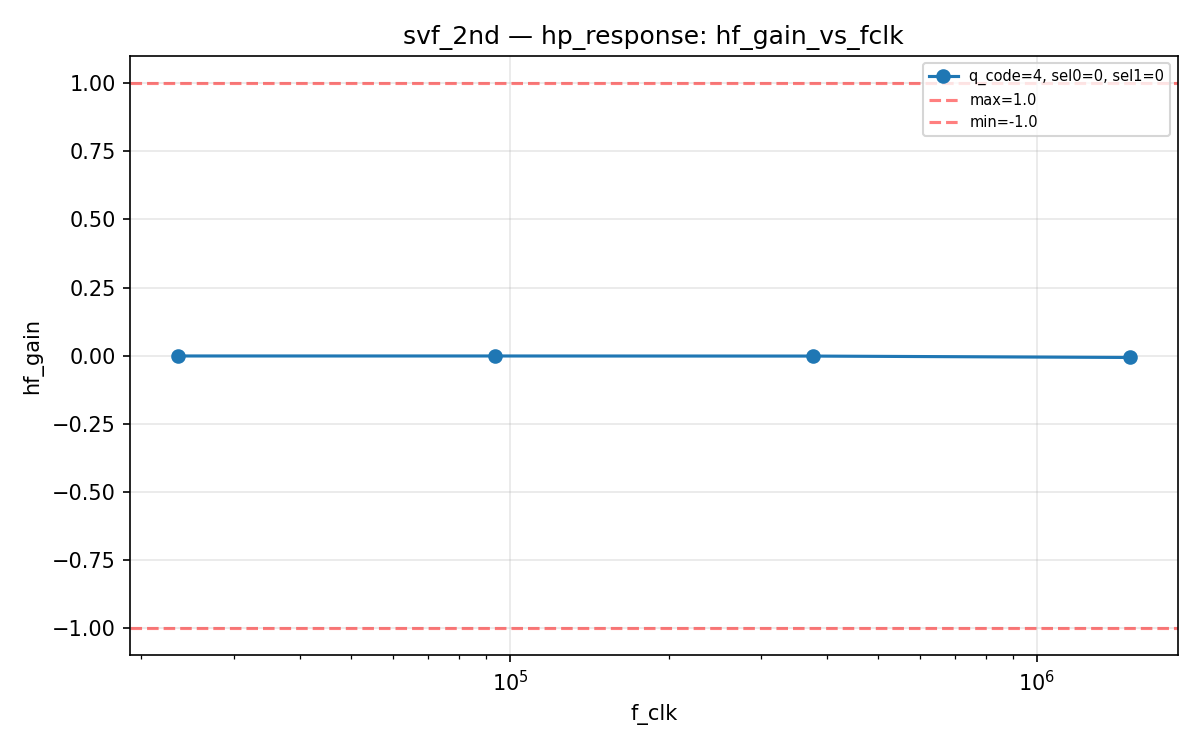
[picture p83: verification/plots/svf_2nd/svf_2nd_hp_response_hf_gain_vs_fclk.png]


### Low-Pass Response

LP mode — DC gain and -3dB frequency

**Specifications:**

| Parameter | Display | Unit | Min | Max |
|---|---|---|-----|-----|
| dc_gain | DC Gain | dB | -1.0 | 1.0 |
| f_3db | -3dB Frequency | Hz | any | any |

**Results:**

| vdd | sel0 | sel1 | f_clk | q_code | dc_gain | f_3db | Status |
|---|---|---|---|---|---|---|---|
| 1.2 | 0 | 1.2 | 23437.5 | 4 | -0.0053 | 66.2975 | PASS |
| 1.2 | 0 | 1.2 | 93750 | 4 | -0.0044 | 265.1339 | PASS |
| 1.2 | 0 | 1.2 | 375000 | 4 | -0.0044 | 1060.5206 | PASS |
| 1.2 | 0 | 1.2 | 1500000 | 4 | -0.0043 | 4242.0739 | PASS |

**Plots:**

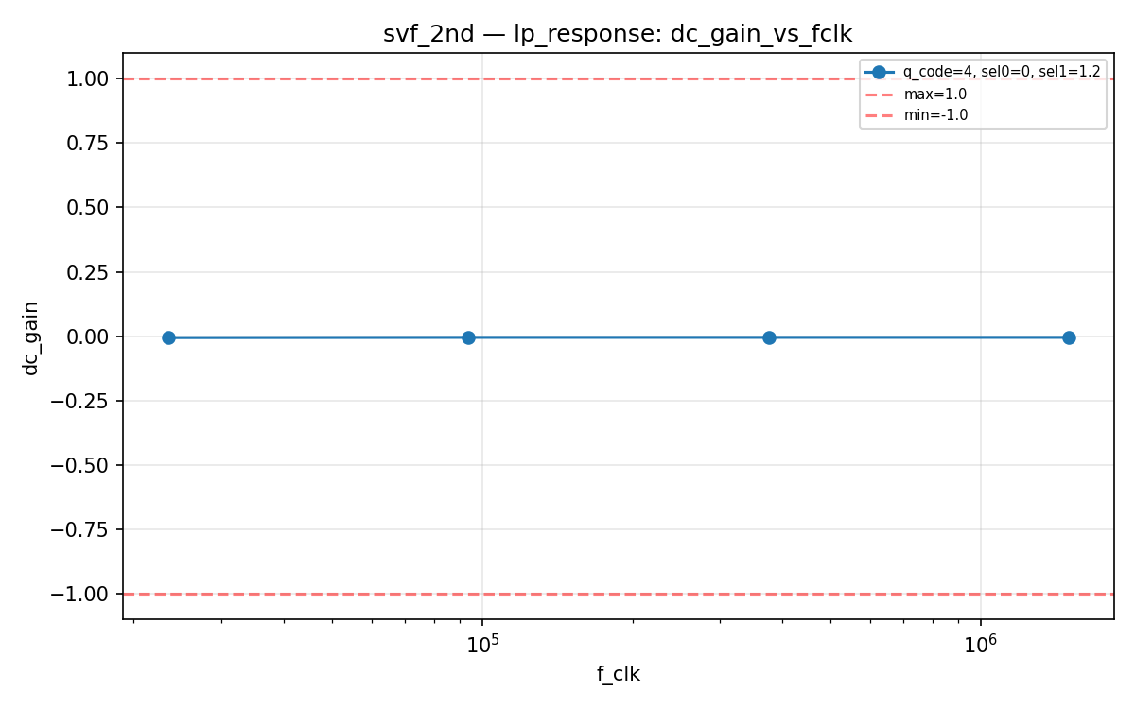
[picture p84: verification/plots/svf_2nd/svf_2nd_lp_response_dc_gain_vs_fclk.png]


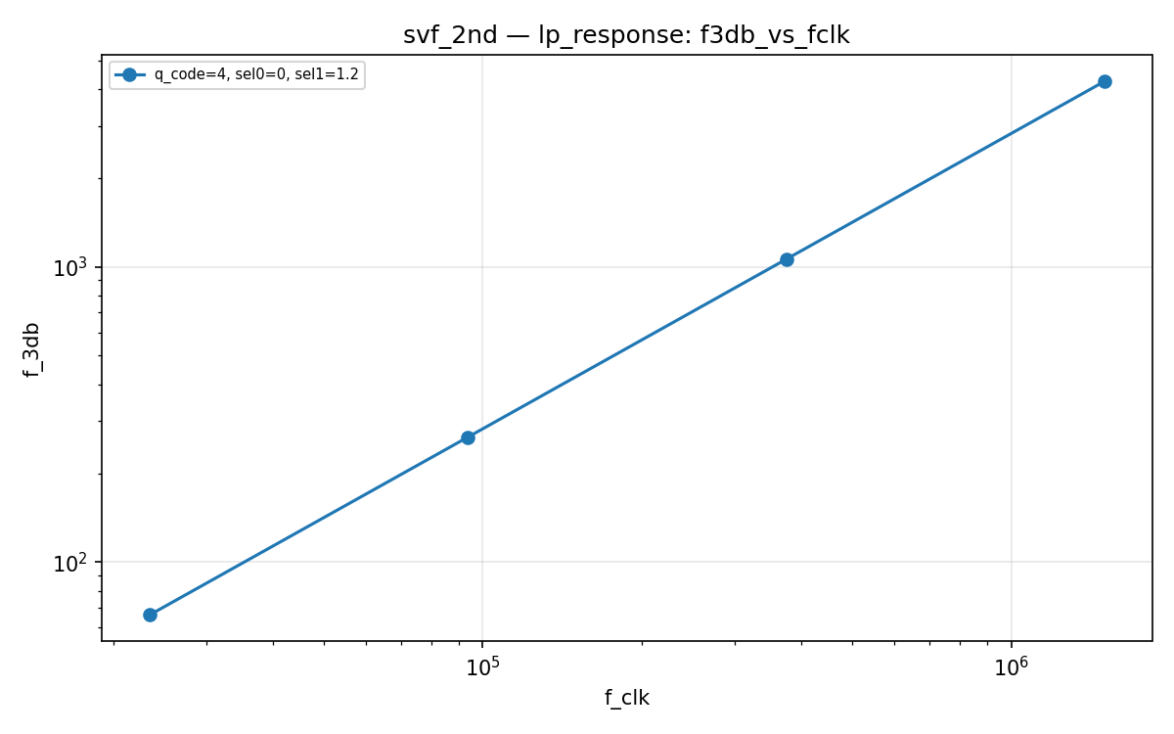
[picture p85: verification/plots/svf_2nd/svf_2nd_lp_response_f3db_vs_fclk.png]


## Composite Plots

### Svf Bp Bode Fclk93K

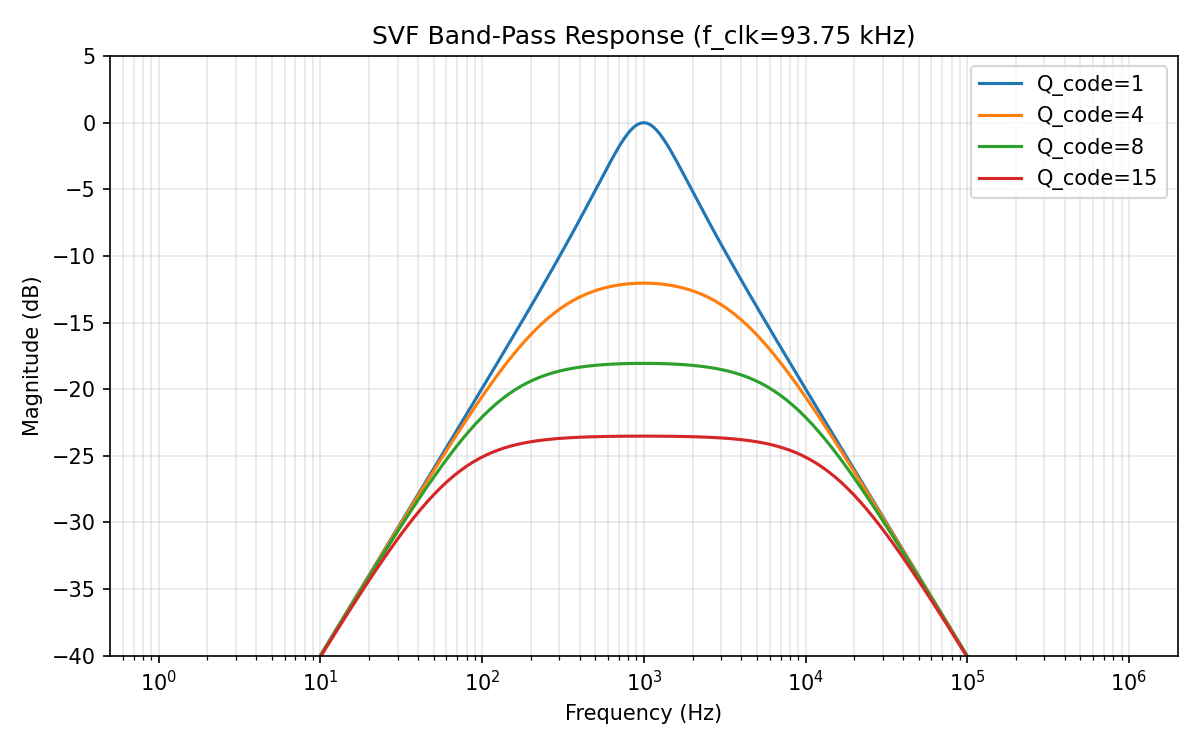
[picture p86: verification/plots/svf_2nd/svf_bp_bode_fclk93k.png]


### Svf Bp Bode Q1

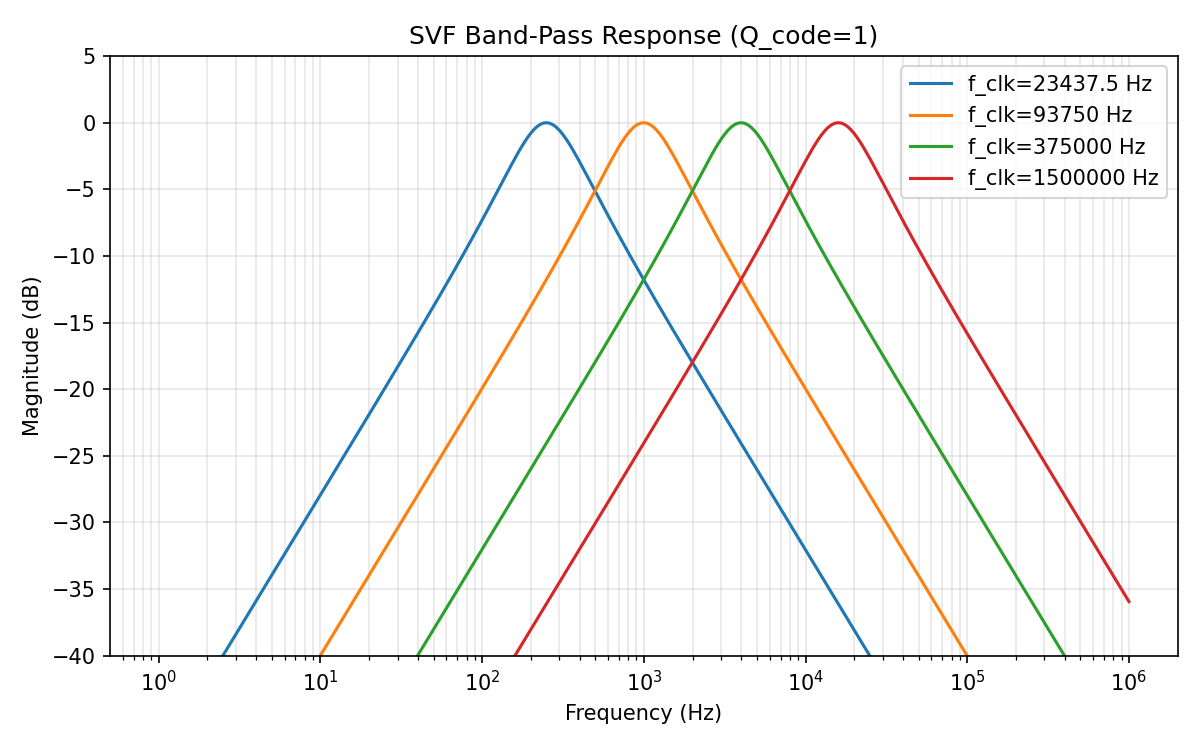
[picture p87: verification/plots/svf_2nd/svf_bp_bode_q1.png]


### Svf Hp Bode

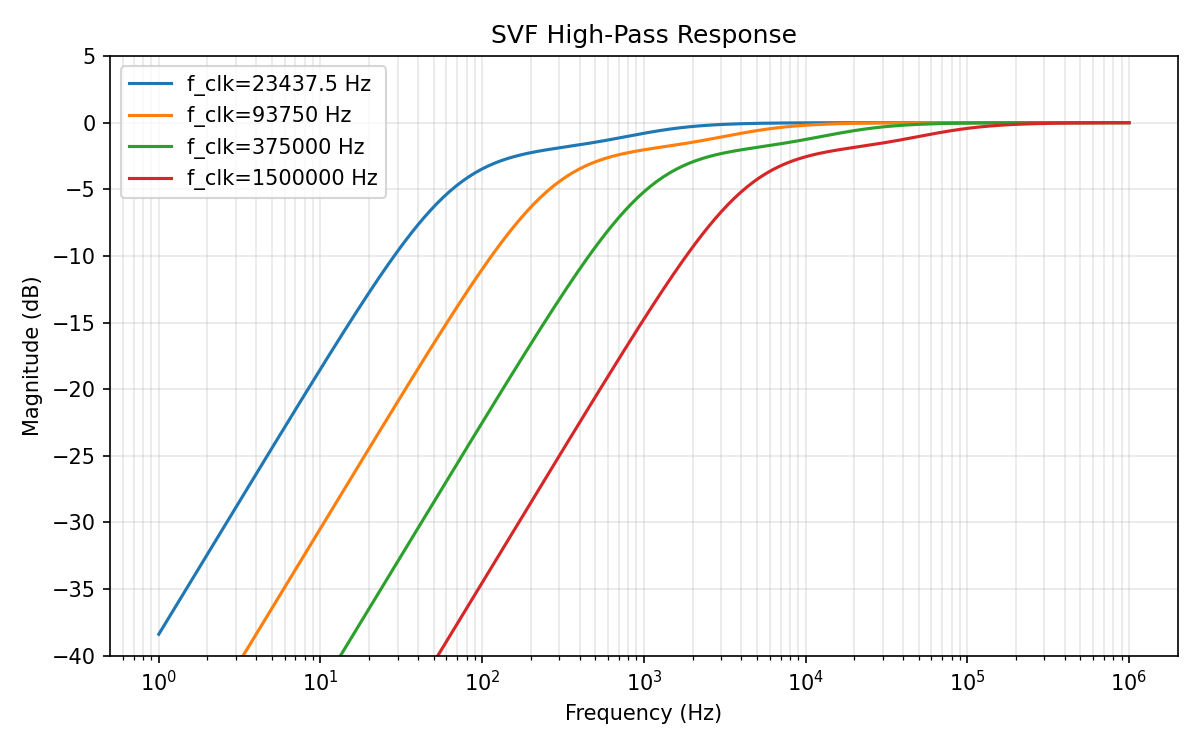
[picture p88: verification/plots/svf_2nd/svf_hp_bode.png]


### Svf Lp Bode

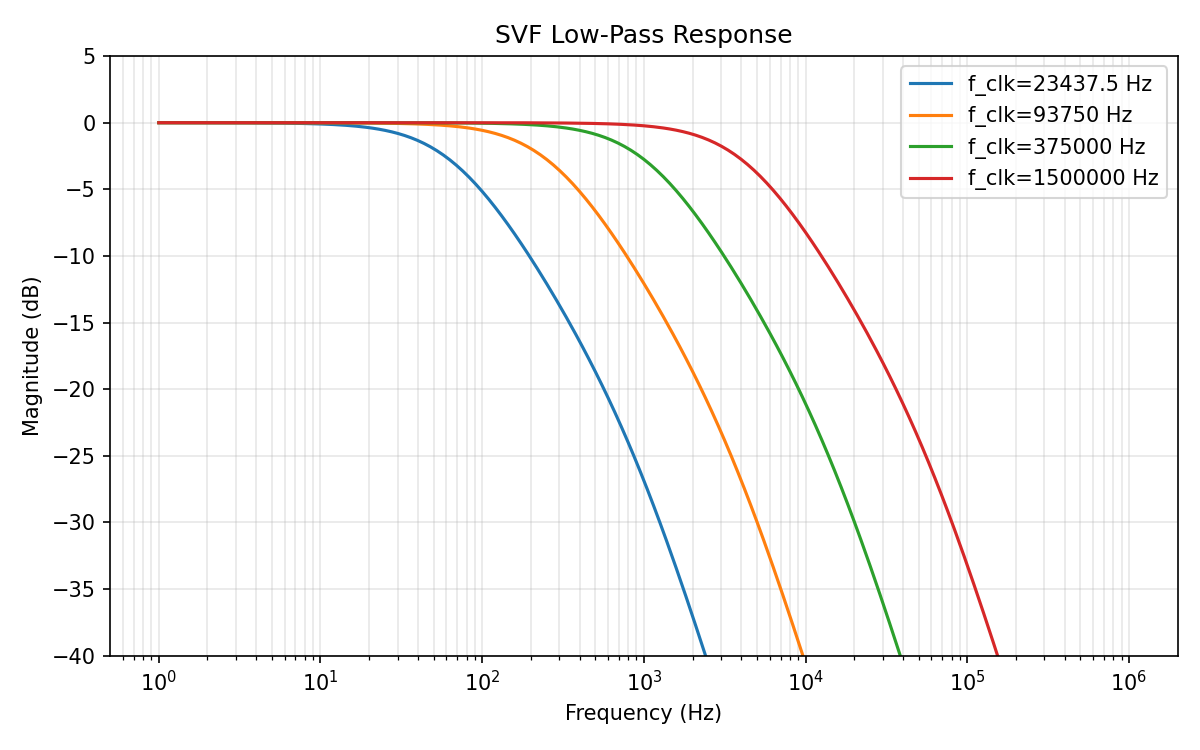
[picture p89: verification/plots/svf_2nd/svf_lp_bode.png]


---
*Generated by run_cace_sims.py on 2026-03-09 15:35:51*
