rrrh/tiny_sid_chip/docs/pwm_testbench_output.png

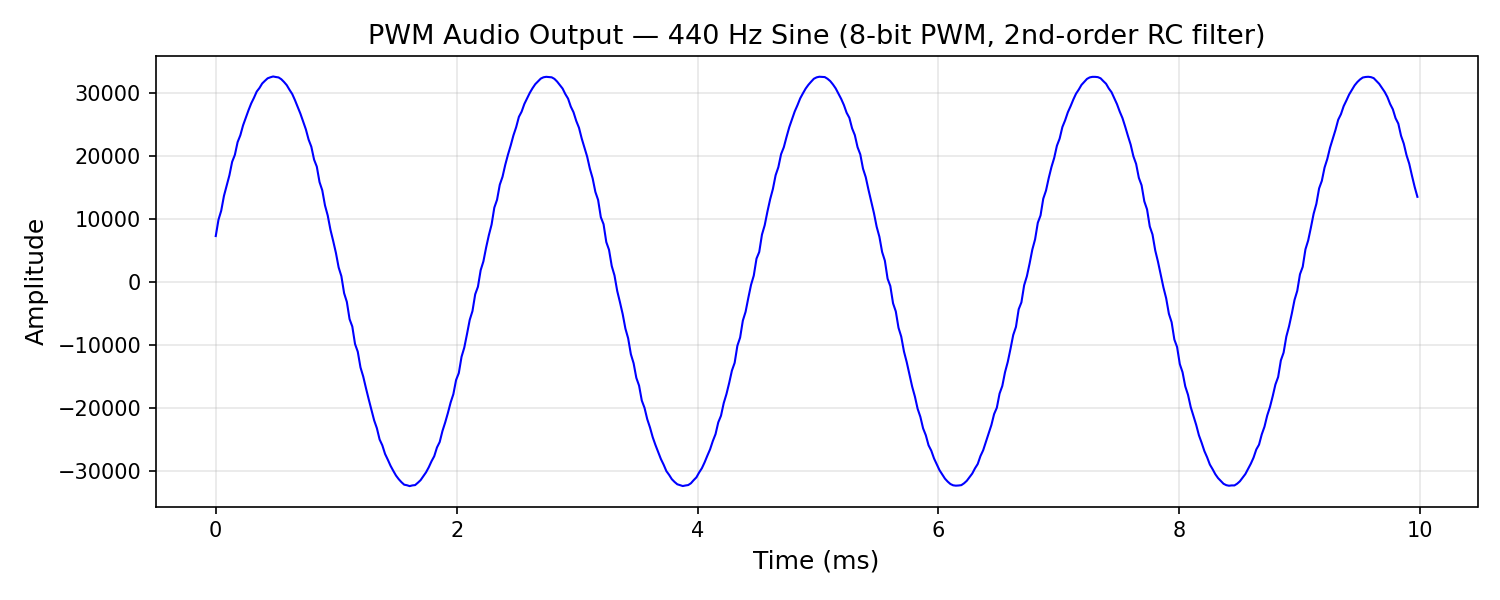
docs/pwm_testbench_output.png
