rrrh/tiny_sid_chip/verification/r2r_dac_8bit/netlist/rcx/r2r_dac_8bit.spice

* NGSPICE file created from r2r_dac_8bit.ext - technology: ihp-sg13g2

.subckt r2r_dac_8bit d0 d1 d2 d3 d4 d5 d6 d7 vout vdd vss
X0 a_1899_4300# a_2651_1900# vss.t7 rhigh l=3.68u w=2u
X1 a_6196_4300# a_6948_1900# vss.t22 rhigh l=3.68u w=2u
X2 a_5229_1900# d5.t0 vdd.t8 vdd.t0 sg13_lv_pmos ad=2.4p pd=12.8u as=2.4p ps=12.8u w=6u l=0.13u
X3 a_3510_1900# d3.t0 vdd.t1 vdd.t0 sg13_lv_pmos ad=2.4p pd=12.8u as=2.4p ps=12.8u w=6u l=0.13u
X4 a_932_1900# d0.t0 vss.t16 vss.t15 sg13_lv_nmos ad=1.2p pd=6.8u as=1.2p ps=6.8u w=3u l=0.13u
X5 a_5237_4800# a_6096_4800# vss.t19 rhigh l=3.675u w=2u
X6 a_3518_4800# a_4377_4800# vss.t14 rhigh l=3.675u w=2u
X7 a_5337_4300# a_6088_1900# vss.t19 rhigh l=3.675u w=2u
X8 a_3618_4300# a_4369_1900# vss.t14 rhigh l=3.675u w=2u
X9 a_2651_1900# d2.t0 vdd.t3 vdd.t0 sg13_lv_pmos ad=2.4p pd=12.8u as=2.4p ps=12.8u w=6u l=0.13u
X10 a_4477_4300# a_5237_4800# vss.t13 rhigh l=3.68u w=2u
X11 a_2659_4800# a_3518_4800# vss.t4 rhigh l=3.675u w=2u
X12 a_2759_4300# a_3510_1900# vss.t4 rhigh l=3.675u w=2u
X13 a_932_1900# d0.t0 vdd.t6 vdd.t0 sg13_lv_pmos ad=2.4p pd=12.8u as=2.4p ps=12.8u w=6u l=0.13u
X14 a_4369_1900# d4.t0 vss.t18 vss.t17 sg13_lv_nmos ad=1.2p pd=6.8u as=1.2p ps=6.8u w=3u l=0.13u
X15 a_940_4800# a_1799_4800# vss.t12 rhigh l=3.675u w=2u
X16 a_1899_4300# a_2659_4800# vss.t7 rhigh l=3.68u w=2u
X17 vdd.t9 a_940_4800# vss.t23 rhigh l=3.68u w=2u
X18 a_6196_4300# vout.t0 vss.t22 rhigh l=3.68u w=2u
X19 a_1040_4300# a_1791_1900# vss.t12 rhigh l=3.675u w=2u
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
C278 a_3682_5280# vss 0.8817f $ **FLOATING
C279 a_3518_4800# vss 0.34255f
C280 a_2823_5280# vss 0.8817f $ **FLOATING
C281 a_2659_4800# vss 0.34255f
C282 a_1963_5280# vss 0.88295f $ **FLOATING
C283 a_1799_4800# vss 0.34255f
C284 a_1104_5280# vss 0.8817f $ **FLOATING
C285 a_940_4800# vss 0.36122f
C286 a_244_5280# vss 0.88641f $ **FLOATING
C287 d7.t0 vss 0.94409f
C288 d6.t0 vss 0.95904f
.ends
