rrrh/tiny_sid_chip/src/tt_um_sid.v

`timescale 1ns / 1ps
/* verilator lint_off UNUSED */
//==============================================================================
// TT10 Wrapper — Time-Multiplexed SID Voice Synthesizer (24 MHz, 3 voices)
//==============================================================================
// 24 MHz system clock, 6 MHz voice pipeline (÷4 clock enable).
// Pipeline register stage between voice mux read and combinatorial datapath
// eliminates most hold violations (~200 buffers → ~10-30).
//
// Slot scheduling (mod-6 counter, gated by clk_en_6m):
//   Slot 4: Latch mix output, Load Voice 0 → p_regs
//   Slot 5: Idle (p_regs hold Voice 0)
//   Slot 0: Compute Voice 0, Load Voice 1 → p_regs
//   Slot 1: Compute Voice 1, Load Voice 2 → p_regs
//   Slot 2: Compute Voice 2 (no load needed)
//   Slot 3: Idle
// Each voice accumulator updates once per 6-clock frame → 1 MHz effective.
//
// Yannes-aligned enhancements:
//   1. 8-bit envelope (256 levels, 48 dB dynamic range)
//   2. Per-voice ADSR parameters (attack, sustain, pulse width)
//   3. Exponential decay (rate adjustment based on envelope thresholds)
//   4. Explicit SUSTAIN state in 4-state envelope FSM (IDLE/ATTACK/DECAY/SUSTAIN)
//   5. Accumulator-clocked 15-bit LFSR (pitch-tracking noise from voice 0)
//   6. Sync modulation (hard sync, circular: V0←V2, V1←V0, V2←V1)
//   7. Ring modulation (XOR other voice MSB into triangle)
//   8. Test bit (zeros accumulator)
//
// Register Map (voice_sel 0–2: per-voice, voice_sel 3: global filter):
//   Per-voice (voice_sel 0–2):
//     0: freq_lo  — frequency[7:0]
//     1: freq_hi  — frequency[15:8]
//     2: pw_lo    — pulse width[7:0]
//     3: pw_hi    — pulse width[11:8] (bits [3:0] only)
//     4: attack   — attack[7:4]/decay[3:0]  (SID $D405)
//     5: sustain  — sustain[7:4]/rel[3:0]  (SID $D406)
//     6: waveform — SID-compatible layout
//   Filter (voice_sel 3):
//     0: fc_lo    — cutoff low [7:0] (fc_hi:fc_lo[2:0] → filt_fc[10:7] → DAC)  ($D415)
//     1: fc_hi    — cutoff high [7:0]                                            ($D416)
//     2: res_filt — [7:4] resonance → Q bias DAC, [3:0] filt enable             ($D417)
//     3: mode_vol — [6:4] mode (HP/BP/LP), [3:0] vol                            ($D418)
//
//   Analog signal chain: vol_scale → R-2R DAC → KHN biquad → comparator → analog PWM
//   sc_clk from NCO phase accumulator, q[3:0] from inverted resonance register
//
// Waveform register (SID $d404 layout):
//   [0] gate  [1] sync  [2] ring-mod  [3] test
//   [4] tri   [5] saw   [6] pulse     [7] noise
//==============================================================================

module tt_um_sid (
    input  wire [7:0] ui_in,
    output wire [7:0] uo_out,
    input  wire [7:0] uio_in,
    output wire [7:0] uio_out,
    output wire [7:0] uio_oe,
    input  wire       ena,
    input  wire       clk,
    input  wire       rst_n
);

    //==========================================================================
    // Input assignments
    //==========================================================================
    wire [4:0] reg_addr  = ui_in[4:0];
    wire [1:0] voice_sel = ui_in[4:3];
    wire       wr_en     = ui_in[7];
    wire [7:0] wr_data   = uio_in;

    //==========================================================================
    // Clock divider: 24 MHz → 6 MHz clock enable (÷4)
    //==========================================================================
    reg [1:0] clk_div;
    wire clk_en_6m = (clk_div == 2'd3);
    always @(posedge clk or negedge rst_n)
        if (!rst_n) clk_div <= 2'd0;
        else        clk_div <= (clk_div == 2'd3) ? 2'd0 : clk_div + 2'd1;

    //==========================================================================
    // Write enable edge detection
    //==========================================================================
    reg wr_en_d;
    always @(posedge clk or negedge rst_n)
        if (!rst_n) wr_en_d <= 1'b0;
        else        wr_en_d <= wr_en;
    wire wr_en_rise = wr_en && !wr_en_d;

    //==========================================================================
    // Slot counter (mod-6, 3-bit)
    //==========================================================================
    reg [2:0] slot;
    always @(posedge clk or negedge rst_n)
        if (!rst_n) slot <= 3'd0;
        else if (clk_en_6m) slot <= (slot == 3'd5) ? 3'd0 : slot + 3'd1;

    wire voice_active = (slot <= 3'd2);
    wire [1:0] voice_idx = slot[1:0];

    //==========================================================================
    // Per-voice register file (3 voices)
    //==========================================================================
    reg [7:0]  freq        [0:2];
    reg [7:0]  freq_hi     [0:2];
    reg [7:0]  waveform    [0:2];
    reg [7:0]  pw_reg      [0:2];
    reg [3:0]  pw_hi       [0:2];
    reg [7:0]  attack_reg  [0:2];
    reg [7:0]  sustain_reg [0:2];

    reg [23:0] acc        [0:2];
    reg [7:0]  env        [0:2];
    reg [1:0]  ast        [0:2];
    reg        gate_latch [0:2];
    reg        releasing  [0:2];
    reg        prev_msb_d [0:2];

    //--- Filter registers (voice_sel == 3) ---
    reg [7:0] fc_lo;
    reg [7:0] fc_hi;
    reg [7:0] res_filt;
    reg [7:0] mode_vol;

    // Derived filter signals
    wire [10:0] filt_fc   = {fc_hi, fc_lo[2:0]};
    wire [3:0]  filt_res  = res_filt[7:4];
    wire [3:0]  filt_en   = res_filt[3:0];
    wire [3:0]  filt_mode = mode_vol[7:4];
    wire [3:0]  filt_vol  = mode_vol[3:0];

    // Register writes (per-voice and filter)
    always @(posedge clk or negedge rst_n) begin
        if (!rst_n) begin
            freq[0] <= 8'd0; freq[1] <= 8'd0; freq[2] <= 8'd0;
            freq_hi[0] <= 8'd0; freq_hi[1] <= 8'd0; freq_hi[2] <= 8'd0;
            waveform[0] <= 8'd0; waveform[1] <= 8'd0; waveform[2] <= 8'd0;
            pw_reg[0] <= 8'd0; pw_reg[1] <= 8'd0; pw_reg[2] <= 8'd0;
            pw_hi[0] <= 4'd0; pw_hi[1] <= 4'd0; pw_hi[2] <= 4'd0;
            attack_reg[0] <= 8'd0; attack_reg[1] <= 8'd0; attack_reg[2] <= 8'd0;
            sustain_reg[0] <= 8'd0; sustain_reg[1] <= 8'd0; sustain_reg[2] <= 8'd0;
            fc_lo <= 8'd0;
            fc_hi <= 8'd0;
            res_filt <= 8'd0;
            mode_vol <= 8'd0;
        end else if (wr_en_rise) begin
            case (reg_addr)
		5'd0: freq[0]        <= wr_data;
		5'd1: freq_hi[0]     <= wr_data;
		5'd2: pw_reg[0]      <= wr_data;
		5'd3: pw_hi[0]       <= wr_data[3:0];
		5'd4: waveform[0]    <= wr_data;
		5'd5: attack_reg[0]  <= wr_data;
		5'd6: sustain_reg[0] <= wr_data;

		5'd7: freq[1]        <= wr_data;
		5'd8: freq_hi[1]     <= wr_data;
		5'd9: pw_reg[1]      <= wr_data;
		5'd10: pw_hi[1]       <= wr_data[3:0];
		5'd11: waveform[1]    <= wr_data;
		5'd12: attack_reg[1]  <= wr_data;
		5'd13: sustain_reg[1] <= wr_data;

		5'd14: freq[2]        <= wr_data;
		5'd15: freq_hi[2]     <= wr_data;
		5'd16: pw_reg[2]      <= wr_data;
		5'd17: pw_hi[2]       <= wr_data[3:0];
		5'd18: waveform[2]    <= wr_data;
		5'd19: attack_reg[2]  <= wr_data;
		5'd20: sustain_reg[2] <= wr_data;

		5'd21: fc_lo          <= wr_data;
		5'd22: fc_hi          <= wr_data;
		5'd23: res_filt       <= wr_data;
		5'd24: mode_vol       <= wr_data[3:0];
                default: ;
            endcase
        end
    end

    //==========================================================================
    // Pipeline registers (~97 FFs, loaded at 6 MHz rate)
    //==========================================================================
    reg [23:0] p_acc;
    reg [23:0] p_freq;
    reg [7:0]  p_waveform;
    reg [11:0] p_pw;
    reg [7:0]  p_env;
    reg [1:0]  p_ast;
    reg        p_gate_latch;
    reg        p_releasing;
    reg [7:0]  p_attack;
    reg [7:0]  p_sustain;
    reg        p_prev_msb_d;
    reg [14:0] p_rate_cnt;
    reg [4:0]  p_expo_cnt;

    // Pipeline load logic
    // Load schedule: slot 4→V0, slot 0→V1, slot 1→V2
    wire load_en = (slot <= 3'd1) || (slot == 3'd4);
    wire [1:0] load_voice = (slot == 3'd4) ? 2'd0 :
                            (slot == 3'd0) ? 2'd1 : 2'd2;

    // Sync source prev_msb_d for pipeline load (flattened, no intermediate mux):
    //   slot 4 → load V0 → sync src V2 → prev_msb_d[2]
    //   slot 0 → load V1 → sync src V0 → prev_msb_d[0]
    //   slot 1 → load V2 → sync src V1 → prev_msb_d[1]
    wire p_prev_msb_d_nxt = (slot == 3'd4) ? prev_msb_d[2] :
                            (slot == 3'd0) ? prev_msb_d[0] : prev_msb_d[1];

    always @(posedge clk or negedge rst_n) begin
        if (!rst_n) begin
            p_acc        <= 24'd0;
            p_freq       <= 24'd0;
            p_waveform   <= 8'd0;
            p_pw         <= 12'd0;
            p_env        <= 8'd0;
            p_ast        <= 2'd0;
            p_gate_latch <= 1'b0;
            p_releasing  <= 1'b0;
            p_attack     <= 8'd0;
            p_sustain    <= 8'd0;
            p_prev_msb_d <= 1'b0;
            p_rate_cnt   <= 15'd0;
            p_expo_cnt   <= 5'd0;
        end else if (clk_en_6m && load_en) begin
            p_acc        <= acc[load_voice];
            p_freq       <= {8'd0, freq_hi[load_voice], freq[load_voice]};
            p_waveform   <= waveform[load_voice];
            p_pw         <= {pw_hi[load_voice], pw_reg[load_voice]};
            p_env        <= env[load_voice];
            p_ast        <= ast[load_voice];
            p_gate_latch <= gate_latch[load_voice];
            p_releasing  <= releasing[load_voice];
            p_attack     <= attack_reg[load_voice];
            p_sustain    <= sustain_reg[load_voice];
            p_prev_msb_d <= p_prev_msb_d_nxt;
            p_rate_cnt   <= rate_cnt[load_voice];
            p_expo_cnt   <= expo_cnt[load_voice];
        end
    end

    //==========================================================================
    // ADSR per-voice rate and exponential counters
    //==========================================================================
    reg [14:0] rate_cnt  [0:2];   // 15-bit rate counter per voice
    reg [4:0]  expo_cnt  [0:2];   // 5-bit exponential counter per voice

    //==========================================================================
    // ADSR state encoding
    //==========================================================================
    localparam [1:0] ENV_IDLE    = 2'd0,
                     ENV_ATTACK  = 2'd1,
                     ENV_DECAY   = 2'd2,
                     ENV_SUSTAIN = 2'd3;

    //==========================================================================
    // Rate period LUT — 4-bit rate index → 15-bit period (SID-accurate)
    //==========================================================================
    function [14:0] rate_period;
        input [3:0] rate;
        begin
            case (rate)
                4'd0:  rate_period = 15'd9;
                4'd1:  rate_period = 15'd32;
                4'd2:  rate_period = 15'd63;
                4'd3:  rate_period = 15'd95;
                4'd4:  rate_period = 15'd149;
                4'd5:  rate_period = 15'd220;
                4'd6:  rate_period = 15'd267;
                4'd7:  rate_period = 15'd313;
                4'd8:  rate_period = 15'd392;
                4'd9:  rate_period = 15'd977;
                4'd10: rate_period = 15'd1954;
                4'd11: rate_period = 15'd3126;
                4'd12: rate_period = 15'd3907;
                4'd13: rate_period = 15'd11720;
                4'd14: rate_period = 15'd19532;
                4'd15: rate_period = 15'd31251;
            endcase
        end
    endfunction

    //==========================================================================
    // Exponential period LUT — 8-bit envelope → 5-bit period (SID-accurate)
    //==========================================================================
    function [4:0] expo_period;
        input [7:0] e;
        begin
            if (e >= 8'd93)       expo_period = 5'd1;
            else if (e >= 8'd54)  expo_period = 5'd2;
            else if (e >= 8'd26)  expo_period = 5'd4;
            else if (e >= 8'd14)  expo_period = 5'd8;
            else if (e >= 8'd6)   expo_period = 5'd16;
            else                  expo_period = 5'd30;
        end
    endfunction

    //==========================================================================
    // Shared LFSR — 15-bit, accumulator-clocked from voice 0
    //==========================================================================
    reg [14:0] shared_lfsr;
    reg        noise_clk_d;
    wire       noise_clk = acc[0][19];
    wire       noise_clk_rise = noise_clk && !noise_clk_d;

    always @(posedge clk or negedge rst_n) begin
        if (!rst_n) begin
            shared_lfsr <= 15'h7FFF;
            noise_clk_d <= 1'b0;
        end else begin
            noise_clk_d <= noise_clk;
            if (noise_clk_rise)
                shared_lfsr <= {shared_lfsr[13:0],
                                shared_lfsr[14] ^ shared_lfsr[13]};
        end
    end

    //==========================================================================
    // Single combinatorial voice datapath (reads from pipeline registers)
    //==========================================================================

    // Cross-voice MSB for sync/ring-mod (flattened, circular: V0←V2, V1←V0, V2←V1)
    wire other_msb = (voice_idx == 2'd0) ? acc[2][23] :
                     (voice_idx == 2'd1) ? acc[0][23] : acc[1][23];
    wire sync_trigger = other_msb && !p_prev_msb_d && p_waveform[1];

    // --- Oscillator with test bit and sync ---
    wire [23:0] nxt_acc = p_waveform[3] ? 24'd0 :       // test bit
                          sync_trigger   ? 24'd0 :       // sync
                          p_acc + p_freq;

    // --- Waveform generation ---
    wire [7:0] saw_out = nxt_acc[23:16];

    // Ring-mod: XOR other voice MSB into triangle MSB
    wire ring_msb = p_waveform[2] ? (nxt_acc[23] ^ other_msb) : nxt_acc[23];
    wire [7:0] tri_out = {nxt_acc[22:16] ^ {7{ring_msb}}, 1'b0};

    wire pulse_cmp = nxt_acc[23:12] >= p_pw;

    reg [7:0] wave_out;
    always @(*) begin
        if (!p_waveform[7] && !p_waveform[6] &&
            !p_waveform[5] && !p_waveform[4])
            wave_out = 8'h00;
        else begin
            wave_out = 8'hFF;
            if (p_waveform[4]) wave_out = wave_out & tri_out;
            if (p_waveform[5]) wave_out = wave_out & saw_out;
            if (p_waveform[6]) wave_out = wave_out & {8{pulse_cmp}};
            if (p_waveform[7]) wave_out = wave_out & shared_lfsr[14:7];
        end
    end

    // --- ADSR rate selection with SID-accurate counters ---
    wire [3:0] sustain_level = p_sustain[7:4];
    wire       cur_gate      = p_waveform[0];

    // Select rate index (no exponential adjustment — expo counter handles it)
    reg [3:0] cur_rate_idx;
    always @(*) begin
        if (p_releasing)
            cur_rate_idx = p_sustain[3:0];
        else case (p_ast)
            ENV_ATTACK:  cur_rate_idx = p_attack[7:4];
            ENV_DECAY:   cur_rate_idx = p_attack[3:0];
            default:     cur_rate_idx = 4'd0;
        endcase
    end

    wire [14:0] cur_period = rate_period(cur_rate_idx);
    wire        in_attack  = !p_releasing && (p_ast == ENV_ATTACK);

    // Rate counter tick: fires when counter reaches 0
    wire rate_tick = (p_rate_cnt == 15'd0);

    // Exponential counter tick: fires when counter reaches 0
    wire expo_tick = (p_expo_cnt == 5'd0);

    // Envelope tick: attack bypasses expo counter
    wire env_tick = rate_tick && (in_attack || expo_tick);

    // --- ADSR next-state logic (8-bit envelope, 4-state FSM) ---
    reg [1:0] nxt_ast;
    reg [7:0] nxt_env;
    reg       nxt_rel;
    always @(*) begin
        nxt_ast = p_ast;
        nxt_env = p_env;
        nxt_rel = p_releasing;
        if (p_releasing) begin
            if (cur_gate && !p_gate_latch) begin
                nxt_rel = 1'b0;
                nxt_ast = ENV_ATTACK;
            end else if (p_env == 8'd0) begin
                nxt_rel = 1'b0;
                nxt_ast = ENV_IDLE;
            end else if (env_tick)
                nxt_env = p_env - 1'b1;
        end else case (p_ast)
            ENV_IDLE: begin
                nxt_env = 8'd0;
                if (cur_gate && !p_gate_latch) nxt_ast = ENV_ATTACK;
            end
            ENV_ATTACK: begin
                if (!cur_gate) nxt_rel = 1'b1;
                else if (p_env == 8'hFF) nxt_ast = ENV_DECAY;
                else if (env_tick) nxt_env = p_env + 1'b1;
            end
            ENV_DECAY: begin
                if (!cur_gate) nxt_rel = 1'b1;
                else if (p_env <= {sustain_level, sustain_level})
                    nxt_ast = ENV_SUSTAIN;
                else if (env_tick) nxt_env = p_env - 1'b1;
            end
            ENV_SUSTAIN: begin
                if (!cur_gate) nxt_rel = 1'b1;
                else if (p_env > {sustain_level, sustain_level} && env_tick)
                    nxt_env = p_env - 1'b1;
                else
                    nxt_env = {sustain_level, sustain_level};
            end
        endcase
    end

    // --- Multiply: 8×8 = 16-bit, take upper 8 bits ---
    wire [15:0] voice_product = wave_out * nxt_env;
    wire [7:0]  voice_out = voice_product[15:8];

    // --- Rate and exponential counter next-value logic ---
    reg [14:0] nxt_rate_cnt;
    reg [4:0]  nxt_expo_cnt;
    always @(*) begin
        // Rate counter: decrement, reload on zero
        if (p_rate_cnt == 15'd0)
            nxt_rate_cnt = cur_period;
        else
            nxt_rate_cnt = p_rate_cnt - 15'd1;

        // Exponential counter: only active during decay/release (not attack)
        if (in_attack) begin
            nxt_expo_cnt = 5'd0;
        end else if (rate_tick) begin
            if (p_expo_cnt == 5'd0)
                nxt_expo_cnt = expo_period(p_env);
            else
                nxt_expo_cnt = p_expo_cnt - 5'd1;
        end else begin
            nxt_expo_cnt = p_expo_cnt;
        end
    end

    //==========================================================================
    // State update on voice slots
    //==========================================================================
    always @(posedge clk or negedge rst_n) begin
        if (!rst_n) begin
            acc[0] <= 24'd0; acc[1] <= 24'd0; acc[2] <= 24'd0;
            env[0] <= 8'd0; env[1] <= 8'd0; env[2] <= 8'd0;
            ast[0] <= ENV_IDLE; ast[1] <= ENV_IDLE; ast[2] <= ENV_IDLE;
            gate_latch[0] <= 1'b0; gate_latch[1] <= 1'b0; gate_latch[2] <= 1'b0;
            releasing[0] <= 1'b0; releasing[1] <= 1'b0; releasing[2] <= 1'b0;
            prev_msb_d[0] <= 1'b0; prev_msb_d[1] <= 1'b0; prev_msb_d[2] <= 1'b0;
            rate_cnt[0] <= 15'd0; rate_cnt[1] <= 15'd0; rate_cnt[2] <= 15'd0;
            expo_cnt[0] <= 5'd0; expo_cnt[1] <= 5'd0; expo_cnt[2] <= 5'd0;
        end else if (clk_en_6m && voice_active) begin
            acc[voice_idx]        <= nxt_acc;
            env[voice_idx]        <= nxt_env;
            ast[voice_idx]        <= nxt_ast;
            gate_latch[voice_idx] <= cur_gate;
            releasing[voice_idx]  <= nxt_rel;
            rate_cnt[voice_idx]   <= nxt_rate_cnt;
            expo_cnt[voice_idx]   <= nxt_expo_cnt;
            // prev_msb_d write: explicit per-slot (avoids computed array index)
            // V0 (slot 0) stores V2's MSB, V1 (slot 1) stores V0's, V2 (slot 2) stores V1's
            case (slot[1:0])
                2'd0: prev_msb_d[2] <= acc[2][23];
                2'd1: prev_msb_d[0] <= acc[0][23];
                2'd2: prev_msb_d[1] <= acc[1][23];
                default: ;
            endcase
        end
    end

    //==========================================================================
    // Mix accumulation (slots 0-2) and latch (slot 3)
    //==========================================================================
    reg [9:0] mix_acc;
    reg [7:0] mix_out;

    always @(posedge clk or negedge rst_n) begin
        if (!rst_n) begin
            mix_acc <= 10'd0;
            mix_out <= 8'd0;
        end else if (clk_en_6m) begin
            case (slot)
                3'd0: mix_acc <= {2'b0, voice_out};
                3'd1: mix_acc <= mix_acc + {2'b0, voice_out};
                3'd2: mix_acc <= mix_acc + {2'b0, voice_out};
                3'd4: begin
                    mix_out <= mix_acc[9:2];
                    mix_acc <= 10'd0;
                end
                default: ;
            endcase
        end
    end

    //==========================================================================
    // Sample-valid strobe: one cycle after slot 4 at 6 MHz rate
    //==========================================================================
    reg sample_valid;
    always @(posedge clk or negedge rst_n)
        if (!rst_n) sample_valid <= 1'b0;
        else        sample_valid <= clk_en_6m && (slot == 3'd4);

    //==========================================================================
    // Analog filter signal chain:
    //   vol_scale → R-2R DAC → KHN biquad → comparator → analog PWM
    //   Ramp DAC (2nd R-2R) generates sawtooth ref for PWM comparator
    //
    // Register mapping (voice_sel=3, flat memory — no SPI):
    //   mode_vol[6:4] → en_lp/en_bp/en_hp (individual filter enables)
    //   mode_vol[3:0] → filt_vol     (digital volume scaling BEFORE DAC)
    //   sc_clk from NCO, q[3:0] from inverted resonance register
    //==========================================================================
    //(* keep *) wire dac_out;           // R-2R DAC analog output
    //(* keep *) wire filter_out;        // SVF analog output
    //(* keep *) wire ramp_out;          // Ramp DAC analog output
    //(* keep *) wire analog_pwm;        // Comparator output (analog PWM)

    // Bypass: no voices routed to filter, or no filter mode selected
    wire bypass = (filt_en[2:0] == 3'd0) || (filt_mode[2:0] == 3'd0);

    // KHN output mixer enables: gate with bypass to silence when not in use
    wire en_lp_w = filt_mode[0] & ~bypass;
    wire en_bp_w = filt_mode[1] & ~bypass;
    wire en_hp_w = filt_mode[2] & ~bypass;

    // --- Volume scaling in digital domain BEFORE the DAC ---
    // shift-add volume: filt_vol[3:0], 0=silent, 15=full
    wire [7:0] vol_mix = (filt_vol[3] ? {1'b0, mix_out[7:1]} : 8'd0) +
                         (filt_vol[2] ? {2'b0, mix_out[7:2]} : 8'd0) +
                         (filt_vol[1] ? {3'b0, mix_out[7:3]} : 8'd0) +
                         (filt_vol[0] ? {4'b0, mix_out[7:4]} : 8'd0);

    // --- R-2R DAC: volume-scaled mixer output → analog ---
    //r2r_dac_8bit u_dac (
    //    .d0(vol_mix[0]), .d1(vol_mix[1]), .d2(vol_mix[2]), .d3(vol_mix[3]),
    //    .d4(vol_mix[4]), .d5(vol_mix[5]), .d6(vol_mix[6]), .d7(vol_mix[7]),
    //    .vout (dac_out)
    //);

    // --- NCO phase accumulator: filt_fc[10:0] → sc_clk ---
    // increment = fc + fc/4 (×5/4 scaling), folded into single accumulator add
    reg [15:0] phase_acc;
    always @(posedge clk or negedge rst_n)
        if (!rst_n) phase_acc <= 16'd0;
        else        phase_acc <= phase_acc + {5'b0, filt_fc} + {7'b0, filt_fc[10:2]};
    wire sc_clk_nco = phase_acc[15];

    // --- Q register inversion: SID res=0 → flat, res=15 → self-oscillation ---
    // q_pins = 15 - filt_res: high q_pins = more Csw_q = lower Q = flatter
    wire [3:0] q_pins = ~filt_res;

    // --- Analog SC+OTA KHN Biquad ---
    //khn_biquad u_svf (
    //    .vin      (dac_out),
    //    .vout     (filter_out),
    //    .en_lp    (en_lp_w),
    //    .en_bp    (en_bp_w),
    //    .en_hp    (en_hp_w),
    //    .sc_clk   (sc_clk_nco),
    //    .q0       (q_pins[0]),
    //    .q1       (q_pins[1]),
    //    .q2       (q_pins[2]),
    //    .q3       (q_pins[3])
    //);

    // --- 8-bit ramp counter for PWM reference (runs at clk = 24 MHz) ---
    // 255-step period (0–254) → 94.1 kHz, matches digital PWM
    reg [7:0] ramp_cnt;
    always @(posedge clk or negedge rst_n)
        if (!rst_n) ramp_cnt <= 8'd0;
        else        ramp_cnt <= (ramp_cnt == 8'd254) ? 8'd0 : ramp_cnt + 8'd1;

    // --- Ramp DAC: converts counter to analog ramp ---
    //r2r_dac_8bit u_ramp_dac (
    //    .d0(ramp_cnt[0]), .d1(ramp_cnt[1]), .d2(ramp_cnt[2]), .d3(ramp_cnt[3]),
    //    .d4(ramp_cnt[4]), .d5(ramp_cnt[5]), .d6(ramp_cnt[6]), .d7(ramp_cnt[7]),
    //    .vout (ramp_out)
    //);

    // --- Comparator: SVF output vs ramp → analog PWM ---
    //pwm_comp u_comp (
    //    .vinp     (dac_out),
    //    .vinn     (ramp_out),
    //    .out      (analog_pwm)
    //);

    // --- Behavioral sim: connect 8-bit data between analog macro models ---
`ifdef BEHAVIORAL_SIM
//    always @(u_dac.sim_data_out) begin
//        u_comp.sim_data_in = u_dec.sim_data_out;
//    end
//    always @(u_ramp_dac.sim_data_out) begin
//        u_comp.sim_ramp_in = u_ramp_dac.sim_data_out;
//    end
`endif

    // --- Digital PWM for bypass path (volume already applied) ---
    wire [7:0] bypass_sample = vol_mix;
    wire digital_pwm;
    pwm_audio u_pwm (
        .clk    (clk),
        .rst_n  (rst_n),
        .sample (bypass_sample),
        .pwm    (digital_pwm)
    );

    // --- Final output: analog PWM when filter active, digital when bypass ---
    wire pwm_out = digital_pwm;

    //==========================================================================
    // Output Pin Mapping
    //==========================================================================
    assign uo_out  = {7'b0, pwm_out};
    assign uio_out = 8'b0;
    assign uio_oe  = 8'b0;

    wire _unused = &{ena, ui_in[6:5], 1'b0};

endmodule
