rrrh/tiny_sid_chip/layout/sg13g2_layers.py

"""
IHP SG13G2 130nm PDK — Layer Map and Design Rules
Source: /data/Projects/chip/IHP-Open-PDK/ihp-sg13g2/libs.tech/klayout/tech/drc/rule_decks/
"""

# ===========================================================================
# GDS Layer Numbers (layer, datatype)
# ===========================================================================
L_ACTIV      = (1, 0)
L_GATPOLY    = (5, 0)
L_CONT       = (6, 0)
L_NSD        = (7, 0)
L_METAL1     = (8, 0)
L_METAL2     = (10, 0)
L_PSD        = (14, 0)
L_VIA1       = (19, 0)
L_SALBLOCK   = (28, 0)
L_VIA2       = (29, 0)
L_METAL3     = (30, 0)
L_NWELL      = (31, 0)
L_CMIM       = (36, 0)
L_THICKGOX   = (44, 0)
L_PWELL      = (46, 0)
L_VIA3       = (49, 0)
L_METAL4     = (50, 0)
L_VIA4       = (66, 0)
L_METAL5     = (67, 0)
L_EXTBLOCK   = (111, 0)
L_TOPVIA1    = (125, 0)
L_TOPMETAL1  = (126, 0)
L_POLYRES    = (128, 0)
L_TOPVIA2    = (133, 0)
L_TOPMETAL2  = (134, 0)

# Pin/label datatypes
L_METAL1_PIN  = (8, 2)
L_METAL1_LBL  = (8, 25)
L_METAL2_PIN  = (10, 2)
L_METAL2_LBL  = (10, 25)
L_METAL3_PIN  = (30, 2)
L_METAL3_LBL  = (30, 25)

# ===========================================================================
# Design Rules (µm) — from DRC rule decks
# ===========================================================================

# Contact (enclosures include +0.01 µm design margin over DRC min)
CONT_SIZE       = 0.16
CONT_SPACE      = 0.18
CONT_ENC_ACTIV  = 0.08   # DRC min 0.07, +0.01 margin
CONT_ENC_GATPOLY = 0.08  # DRC min 0.07, +0.01 margin
CONT_ENC_M1     = 0.07   # M1 pad = (0.16+0.14)² = 0.09µm² ≥ M1.d min area

# Metal1
M1_WIDTH        = 0.16
M1_SPACE        = 0.18

# Metal2+
M2_WIDTH        = 0.20
M2_SPACE        = 0.21
M3_SPACE        = 0.21
M4_SPACE        = 0.21

# pSD implant
PSD_ENC_ACTIV   = 0.18   # pSD.c: min pSD enclosure of Activ
PSD_ENC_GATE    = 0.30   # pSD.i: min pSD enclosure in gate direction

# Via1
VIA1_SIZE       = 0.19
VIA1_SPACE      = 0.22
VIA1_ENC_M1     = 0.01
VIA1_ENC_M2     = 0.10   # pad = 0.39µm → area ≥ 0.144µm² (M2.d)

# Via2
VIA2_SIZE       = 0.19
VIA2_SPACE      = 0.22
VIA2_ENC_M2     = 0.10
VIA2_ENC_M3     = 0.10

# Via3
VIA3_SIZE       = 0.19
VIA3_SPACE      = 0.22
VIA3_ENC_M3     = 0.10
VIA3_ENC_M4     = 0.10

# Via4
VIA4_SIZE       = 0.19
VIA4_SPACE      = 0.22
VIA4_ENC_M4     = 0.10
VIA4_ENC_M5     = 0.10

# TopVia1
TOPVIA1_SIZE    = 0.42
TOPVIA1_SPACE   = 0.42
TOPVIA1_ENC_M5  = 0.10
TOPVIA1_ENC_TM1 = 0.42

# GatPoly
GATPOLY_WIDTH   = 0.13  # min gate length (1.2V)
GATPOLY_SPACE   = 0.18
GATPOLY_EXT     = 0.18  # extension past Activ

# Activ
ACTIV_WIDTH     = 0.15
ACTIV_SPACE     = 0.21

# NWell
NWELL_WIDTH     = 0.62
NWELL_SPACE     = 0.62       # same-net NWell space (NW.b)
NWELL_SPACE_DN  = 1.80       # different-net NWell-to-NWell (NW.b1)
NWELL_ENC_ACTIV = 0.31

# Source/drain extension: must satisfy Activ enclosure, Cnt.f gate spacing, AND M1.b pad spacing
# sd_ext >= max(CONT_SIZE + 2*CONT_ENC_ACTIV,     — Activ enclosure of contact
#               CONT_SIZE + 2*0.11,                 — Cnt.f: contact to gate >= 0.11µm
#               M1_SPACE + CONT_SIZE + 2*CONT_ENC_M1 - GATPOLY_WIDTH)  — M1.b for L_min
SD_EXT          = 0.38       # = max(0.32, 0.38, 0.35)

# SalBlock (for resistors)
SAL_ENC_GATPOLY = 0.20
SAL_SPACE_CONT  = 0.20
SAL_MIN_LEN     = 0.50

# MIM capacitor
MIM_MIN_SIZE    = 1.14
MIM_SPACE       = 0.60
MIM_ENC_M5      = 0.60   # Metal5 enclosure of Cmim

# rppd resistor
RPPD_SHEET_R    = 315.0   # Ω/sq (typical)
MIM_CAP_DENSITY = 1.5     # fF/µm²


# ===========================================================================
# Helper: create a KLayout layout with the layer map registered
# ===========================================================================
import klayout.db as pya

def snap5(val):
    """Snap value to 5nm manufacturing grid."""
    return round(val / 0.005) * 0.005

def new_layout(dbu=0.001):
    """Create a layout with dbu in µm (0.001 = 1nm grid)."""
    layout = pya.Layout()
    layout.dbu = dbu
    return layout

def um(val):
    """Convert µm to database units (1nm grid), snapped to 5nm."""
    return int(round(val / 0.005) * 5)

def rect(x1, y1, x2, y2):
    """Create a pya.Box from µm coordinates, snapped to 5nm grid."""
    return pya.Box(um(x1), um(y1), um(x2), um(y2))

def add_pin_label(cell, layer_pin, layer_lbl, box, name, layout):
    """Add a pin rectangle, drawing layer, and text label."""
    li_pin = layout.layer(*layer_pin)
    li_lbl = layout.layer(*layer_lbl)
    li_drw = layout.layer(layer_pin[0], 0)  # drawing layer (same layer num, datatype 0)
    cell.shapes(li_pin).insert(box)
    cell.shapes(li_drw).insert(box)  # DRC requires drawing under pin
    cx = (box.left + box.right) // 2
    cy = (box.bottom + box.top) // 2
    cell.shapes(li_lbl).insert(pya.Text(name, pya.Trans(cx, cy)))


def draw_ptap(cell, layout, x, y, w=0.36, h=0.36):
    """Draw a P+ substrate tap (PWell tie) for latch-up protection.
    Places pSD+Activ+Contact+Metal1 at (x,y) with given size.
    Must be within 20µm of any NMOS (LU.b rule)."""
    li_act  = layout.layer(*L_ACTIV)
    li_psd  = layout.layer(*L_PSD)
    li_cnt  = layout.layer(*L_CONT)
    li_m1   = layout.layer(*L_METAL1)
    # Activ
    cell.shapes(li_act).insert(rect(x, y, x + w, y + h))
    # pSD implant (with enclosure — pSD.c ≥ 0.18µm)
    psd_enc = 0.18
    cell.shapes(li_psd).insert(rect(x - psd_enc, y - psd_enc, x + w + psd_enc, y + h + psd_enc))
    # Contact (centered)
    cx = x + (w - CONT_SIZE) / 2
    cy = y + (h - CONT_SIZE) / 2
    cell.shapes(li_cnt).insert(rect(cx, cy, cx + CONT_SIZE, cy + CONT_SIZE))
    # Metal1 pad
    cell.shapes(li_m1).insert(rect(cx - CONT_ENC_M1, cy - CONT_ENC_M1,
                                    cx + CONT_SIZE + CONT_ENC_M1,
                                    cy + CONT_SIZE + CONT_ENC_M1))


def draw_ntap(cell, layout, x, y, w=0.36, h=0.36):
    """Draw an N+ NWell tie for latch-up protection (LU.a).
    Places Activ+Contact+Metal1 inside NWell at (x,y).
    IHP SG13G2: ntap = nactiv inside NWell (no nSD needed)."""
    li_act  = layout.layer(*L_ACTIV)
    li_cnt  = layout.layer(*L_CONT)
    li_m1   = layout.layer(*L_METAL1)
    li_nw   = layout.layer(*L_NWELL)
    # NWell (local, merges with existing NWell)
    nw_enc = NWELL_ENC_ACTIV
    cell.shapes(li_nw).insert(rect(x - nw_enc, y - nw_enc, x + w + nw_enc, y + h + nw_enc))
    # Activ (no pSD, no nSD — nactiv by default)
    cell.shapes(li_act).insert(rect(x, y, x + w, y + h))
    # Contact (centered)
    cx = x + (w - CONT_SIZE) / 2
    cy = y + (h - CONT_SIZE) / 2
    cell.shapes(li_cnt).insert(rect(cx, cy, cx + CONT_SIZE, cy + CONT_SIZE))
    # Metal1 pad
    cell.shapes(li_m1).insert(rect(cx - CONT_ENC_M1, cy - CONT_ENC_M1,
                                    cx + CONT_SIZE + CONT_ENC_M1,
                                    cy + CONT_SIZE + CONT_ENC_M1))
